karlp/ktwinkler/README.md

# kTwinkler

Replacement controller board for some "common" battery powered led fairy lights...
