karlp/ktwinkler/fw/README.md

# fw options
Given that there's multiple boards, with multiple hardwares in this repo, the firmware really has a few options.  At the time of writing, work is focused on esp32 variants, and using them with home assistant, and/or Artnet or sACN/E1.31

# micropython builds

## One time prep
We prefer using idf in a container, however, the original "make submodules" targets inside esp32 aren't happy with that.  Just update the submodules we know ahead of time.
```
git submodule update --init lib/micropython-lib lib/berkeley-db-1.xx
```

## (re)build
(The extra .. is so that _this_ repo's top level git repository is accessible for versioning)
```
podman run --rm -v ..:/project:Z -w /project/fw/boards/ktwinkler-multi-r2025-12 -e HOME=/tmp docker.io/espressif/idf:v5.5.4 idf.py  build
podman run --rm -v ..:/project:Z -w /project/fw/boards/ktwinkler-24-basic1 -e HOME=/tmp docker.io/espressif/idf:v5.5.4 idf.py -b 921660 build
```

# To flash.
```
podman run --rm --device /dev/ttyACM0 -v ..:/project:Z -w /project/fw/boards/ktwinkler-multi-r2025-12 -e HOME=/tmp docker.io/espressif/idf:v5.5.4 idf.py -b 921660 build erase-flash flash
podman run --rm --device /dev/ttyACM0 -v ..:/project:Z -w /project/fw/boards/ktwinkler-24-basic1 -e HOME=/tmp docker.io/espressif/idf:v5.5.4 idf.py -b 921660 build erase-flash flash
```
