karlp/ktwinkler/notes.halloween.2026.md

# For next year
## use one of the 40V nmosx4 boards to be an artnet+skeleton arms controller.
This will:
 - save a bunch of separate cabling
 - be signifcantly less hassle remembering how to wire up a faker board.

## While I'm at it, order some other shit that turned up:

* 3.5mm x2 wire side, fistful
* banana to screw jack?
* banana to wire for making my own alternate leads.  somehow I'v erun out

## Get a pile of 2 terminal waterproof connectors
Using the euroconnectors is... pretty ish for icelandic weather.

### https://www.aliexpress.com/item/1005013383786555.html
  IDC, no three way, claims 6A, no waterproof claims

### https://www.aliexpress.com/item/1005012276167495.html
"M12" but wow, need to be careful with the keying.
This sort of thing though...

### https://www.aliexpress.com/item/1005007842926046.html
"weipo" style, way too expensive

### https://www.aliexpress.com/item/1005006974116902.html
screw together with lever connectors inside?
might be more flexible for multiple wire sizes?
but, no, I want.... m12 style to hang out of everything, it's the easiest, then mount long lines to each led string I need?

### winner, m12, flat side, extensions and bare ends
https://www.aliexpress.com/item/1005006619215145.html
need to find the female end for putting into the control boxes...

### alternate, m12, notched key,
female and male options, pigtails, 
https://www.aliexpress.com/item/1005010790895370.html

honestly, that keying style does actaully seem yo be more prevalent?

### https://www.aliexpress.com/item/1005012783296378.html
"CableMate store"
same notched style, offers different gauge wire, which instantly makes me trust them more :)

GO over this again. m10, vs m12, vs m16!!!
