karlp/ktwinkler/scifi/EMerge_example_pack_2_2/examples/DielectricRod.step

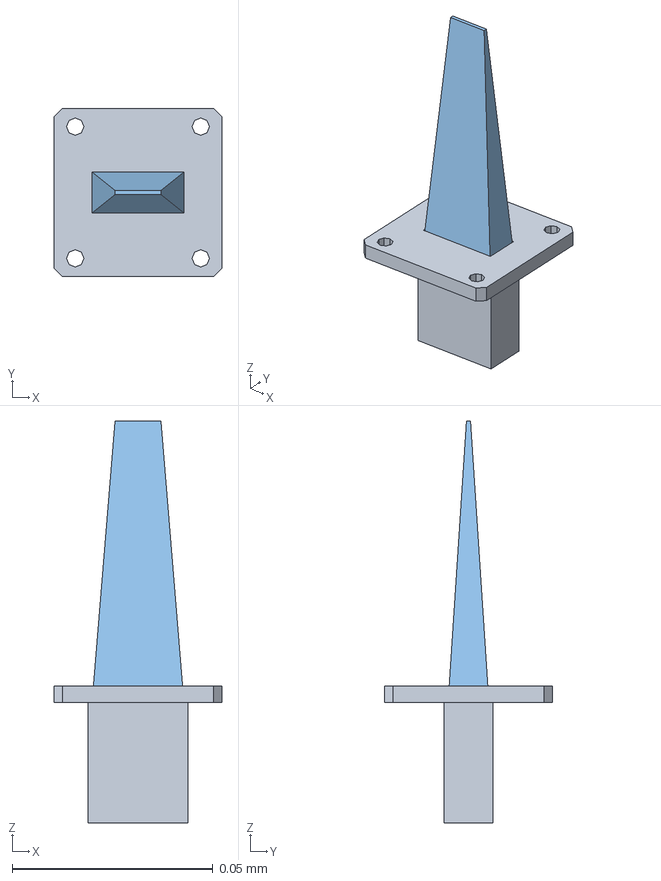
[picture p1: CAD file, 2025-12-28]
scifi/EMerge_example_pack_2_2/examples/DielectricRod.step
0.0417 x 0.0417 x 0.1 mm
