karlp/ktwinkler/hw/ktwinkler-24-basic1/ktwinkler-24-basic1.kicad_pcb

## KiCad design hw/ktwinkler-24-basic1/ktwinkler-24-basic1.kicad_pcb (2026-09-21)

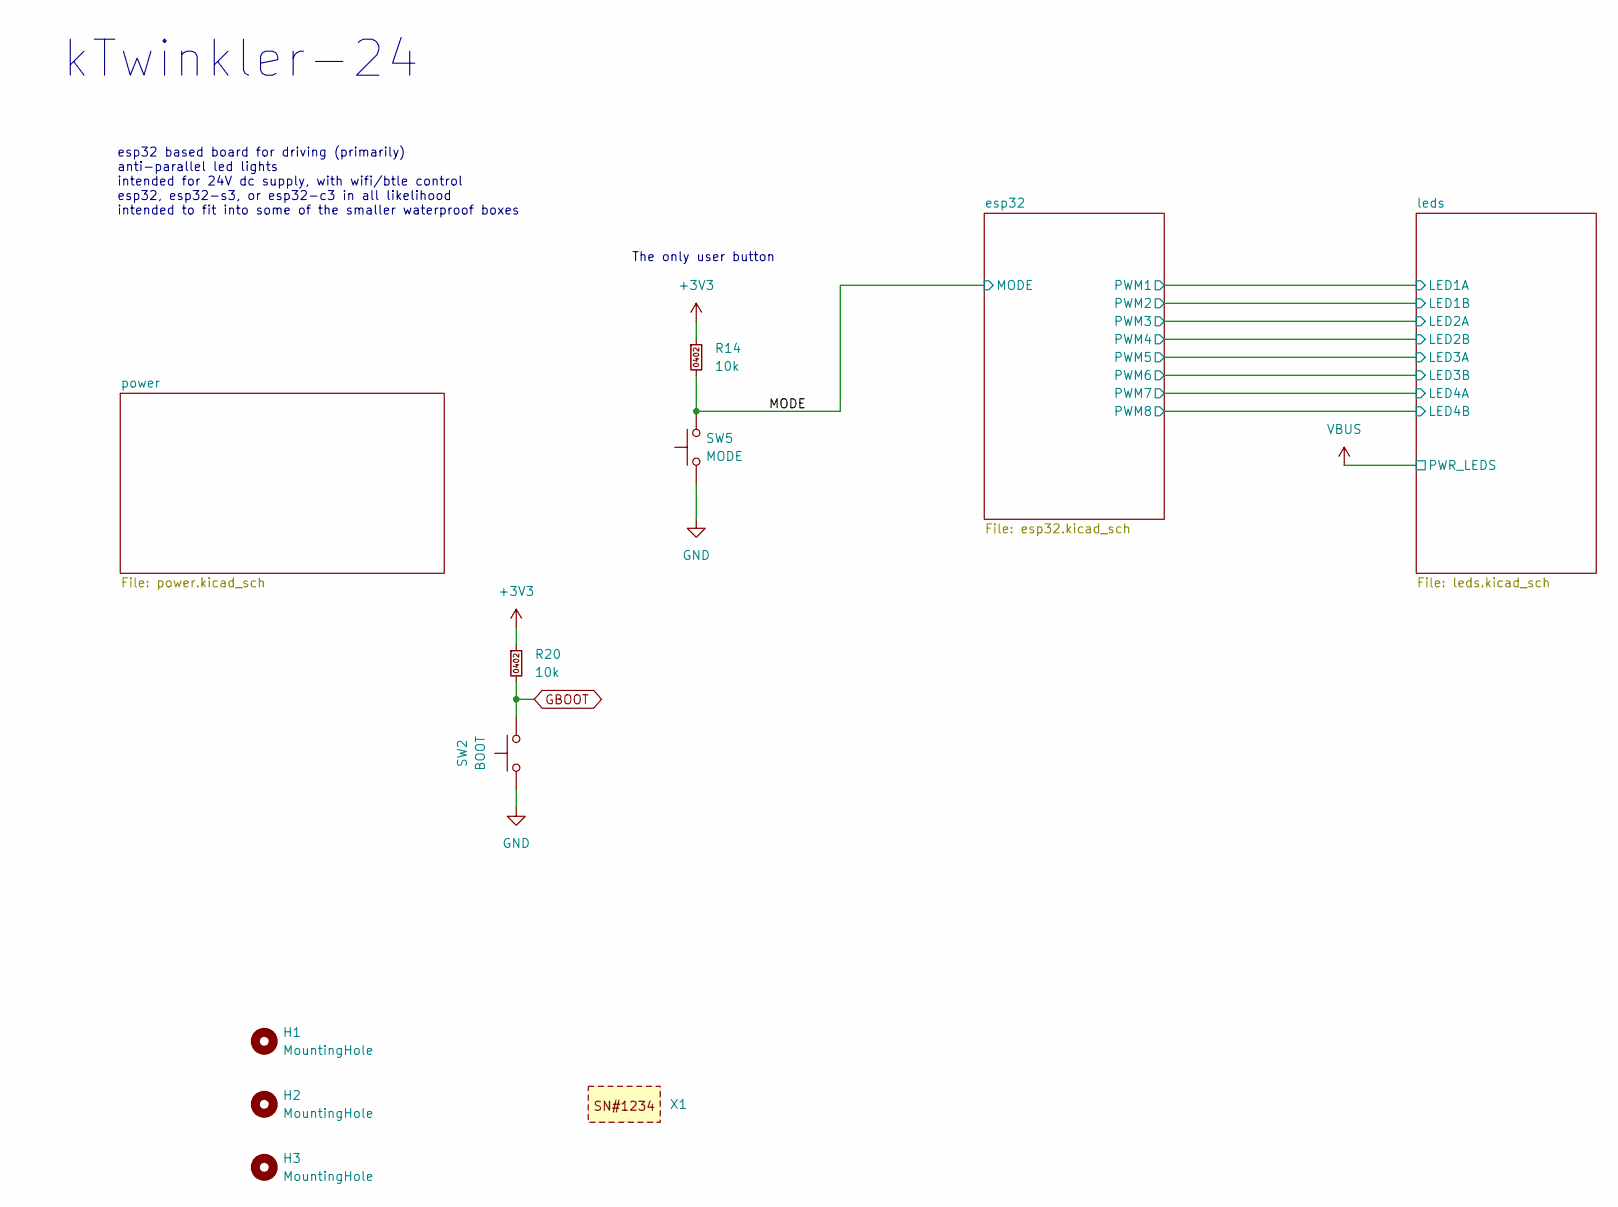
[picture p2: schematic ktwinkler-24-basic1.kicad_sch]

Parts:
H1, H2, H3: MountingHole; MountingHole_3.2mm_M3
R14, R20: 10k; R_0402_1005Metric; MPN 0402WGF1002TCE; LCSC Part # C25744
SW2: BOOT; SW_SPST_TL3342; MPN TS-1187A-B-A-B; jlcbasic basic
SW5: MODE; SW_SPST_TL3342; MPN TS-1187A-B-A-B; jlcbasic basic
X1: JLC_2D_BARCODE_8x8mm

Connections:
+3V3: R14.1, R20.1; also elsewhere on the board
/MODE: R14.2, SW5.2; also elsewhere on the board
GBOOT: R20.2, SW2.2; also elsewhere on the board
GND: SW2.1, SW5.1; also elsewhere on the board

Notes on the sheet:
esp32 based board for driving (primarily) anti-parallel led lights intended for 24V dc supply, with wifi/btle control esp32, esp32-s3, or esp32-c3 in all likelihood intended to fit into some of the smaller waterproof boxes
kTwinkler-24
The only user button

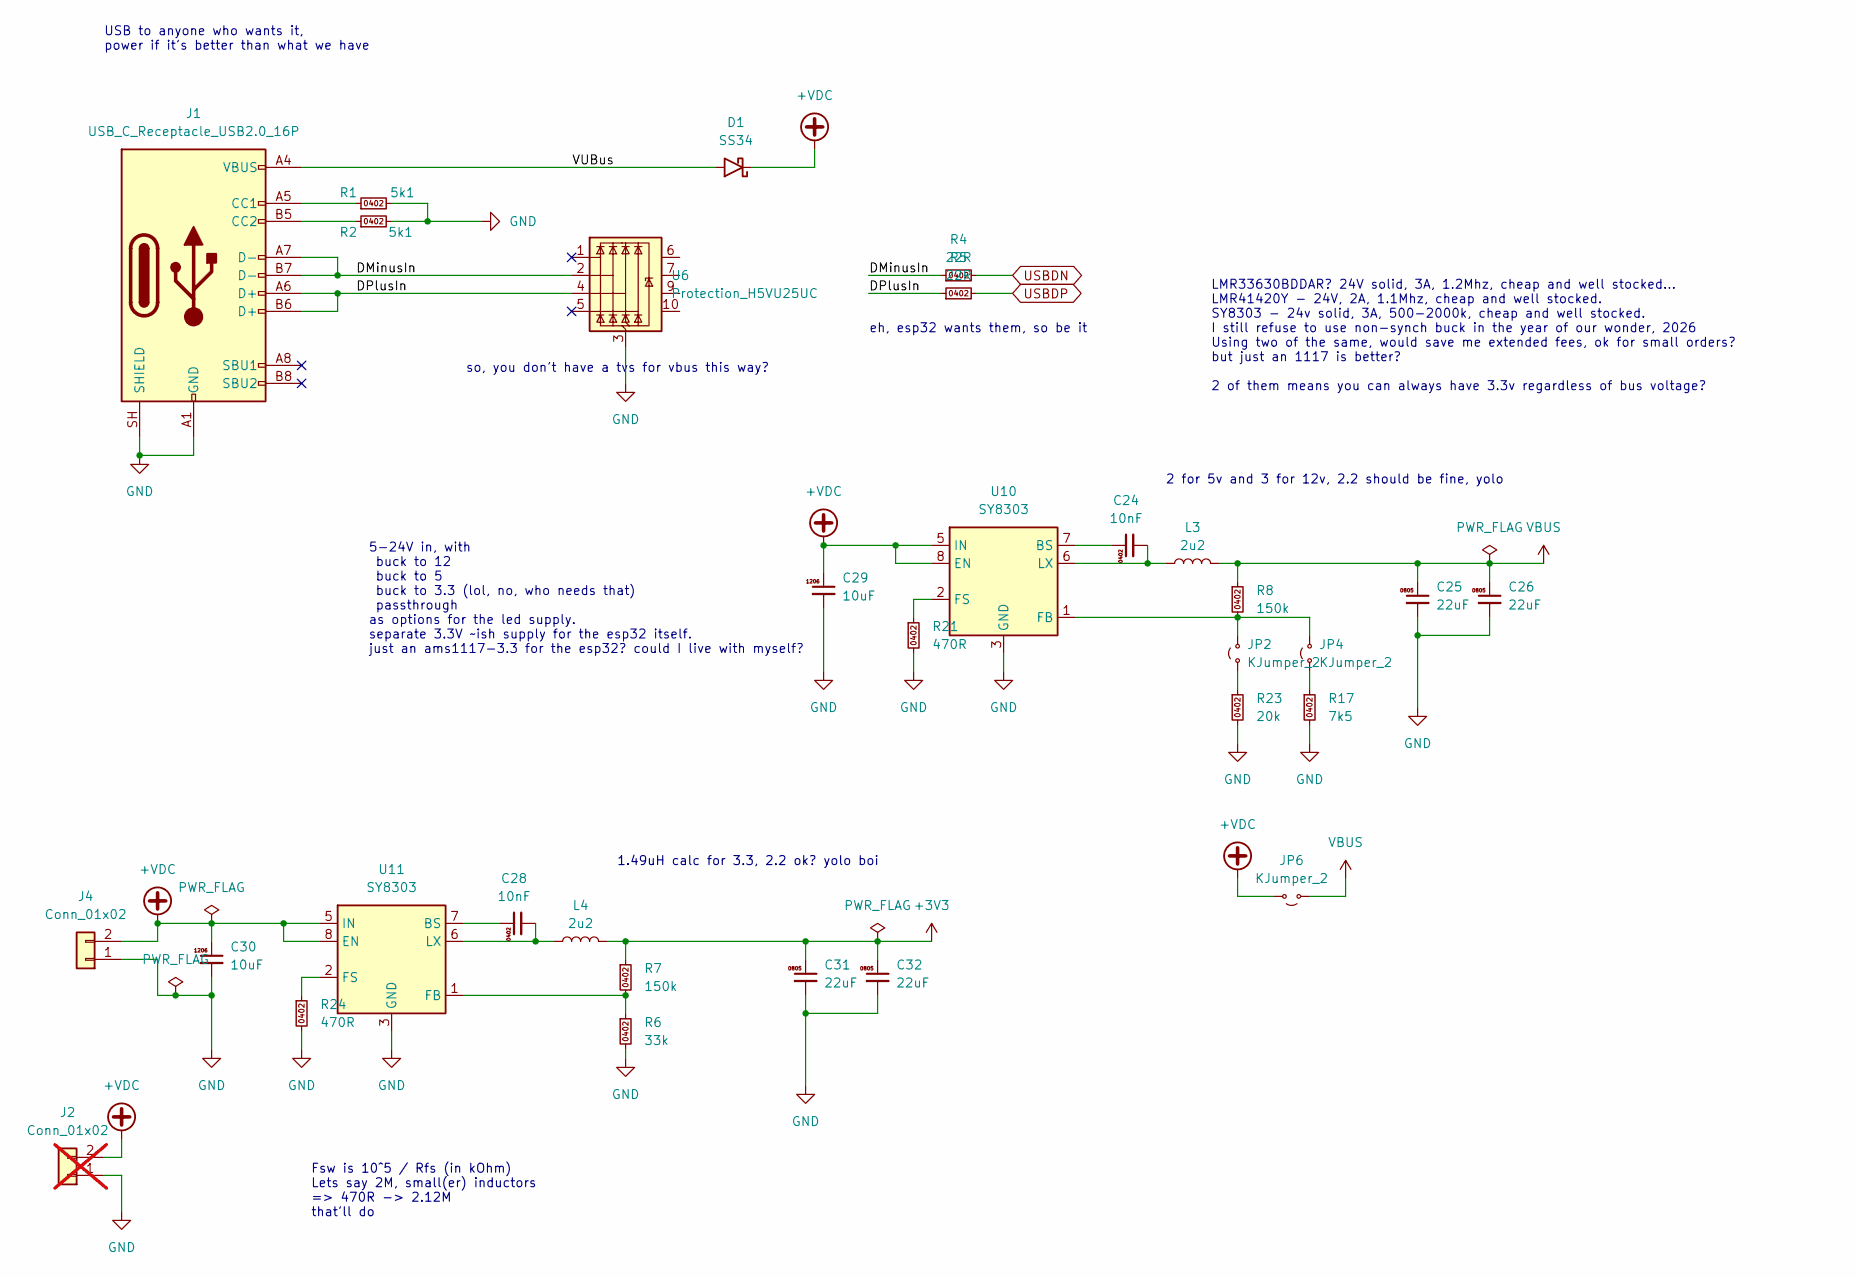
[picture p3: schematic power.kicad_sch]

Parts:
C24, C28: 10nF; C_0402_1005Metric; MPN CL05B103KB5NNNC; LCSC Part # C15195
C25, C26, C31, C32: 22uF; C_0805_2012Metric; MPN CL21A226MAQNNNE; LCSC Part # C45783
C29, C30: 10uF; C_1206_3216Metric; MPN CL31A106KBHNNNE; LCSC Part # C13585
D1: SS34; D_SMA; MPN SS34; LCSC Part # C8678
J1: USB_C_Receptacle_USB2.0_16P; USB_C_Receptacle_GCT_USB4105-xx-A_16P_TopMnt_Horizontal; MPN GT-USB-7010ASV; LCSC Part # C2988369
J2: Conn_01x02; PinHeader_1x02_P2.54mm_Vertical; not fitted
J4: Conn_01x02; PhoenixContact_MCV_1,5_2-G-3.81_1x02_P3.81mm_Vertical; MPN WJ15EDGVC-3.81-02P-14-00A; LCSC Part # C8396
JP2, JP4, JP6: KJumper_2; PinHeader_1x02_P2.54mm_Vertical
L3, L4: 2u2; L_Changjiang_FNR4030S; MPN FNR4030S2R2MT; LCSC Part # C167869
R1, R2: 5k1; R_0402_1005Metric; MPN 0402WGF5101TCE; LCSC Part # C25905
R4, R5: 22R; R_0402_1005Metric; MPN 0402WGF220JTCE; LCSC Part # C25092
R6: 33k; R_0402_1005Metric; MPN 0402WGF3302TCE; LCSC Part # C25779
R7, R8: 150k; R_0402_1005Metric; MPN 0402WGF1503TCE; LCSC Part # C25755
R17: 7k5; R_0402_1005Metric; MPN 0402WGF7501TCE; LCSC Part # C25918
R21, R24: 470R; R_0402_1005Metric; MPN 0402WGF4700TCE; LCSC Part # C25117
R23: 20k; R_0402_1005Metric; MPN 0402WGF2002TCE; LCSC Part # C25765
U6: Protection_H5VU25UC; Diodes_UDFN-10_1x2.5mm_P0.5mm; MPN H5VU25UC; jlcbasic preferred
U10, U11: SY8303; TSOT-23-8; LCSC Part # C97054

Connections:
+3V3: C31.1, C32.1, L4.2, R7.1; also elsewhere on the board
+VDC: C29.1, C30.1, D1.1 (K), J2.2, J4.2, JP6.2 (B), U10.5 (IN), U10.8 (EN), U11.5 (IN), U11.8 (EN)
/power/DMinusIn: J1.A7 (D-), J1.B7 (D-), R4.1, U6.2 (I/O2)
/power/DPlusIn: J1.A6 (D+), J1.B6 (D+), R5.1, U6.4 (I/O3)
/power/VUBus: D1.2 (A), J1.A4 (VBUS), J1.A9 (VBUS), J1.B4 (VBUS), J1.B9 (VBUS)
GND: C25.2, C26.2, C29.2, C30.2, C31.2, C32.2, J1.A1 (GND), J1.A12 (GND), J1.B1 (GND), J1.B12 (GND), J1.SH (SHIELD), J2.1, J4.1, R1.2, R2.2, R6.2, R17.2, R21.2, R23.2, R24.2, U6.3 (GND), U6.8 (GND), U10.3 (GND), U10.4 (GND), U11.3 (GND), U11.4 (GND); also elsewhere on the board
unnamed: J1.A5 (CC1), R1.1
unnamed: J1.B5 (CC2), R2.1
unnamed: JP2.1 (A), R23.1
unnamed: JP2.2 (B), JP4.2 (B), R8.2, U10.1 (FB)
unnamed: JP4.1 (A), R17.1
unnamed: C24.1, U10.7 (BS)
unnamed: R21.1, U10.2 (FS)
unnamed: C24.2, L3.1, U10.6 (LX)
unnamed: C28.1, U11.7 (BS)
unnamed: R6.1, R7.2, U11.1 (FB)
unnamed: R24.1, U11.2 (FS)
unnamed: C28.2, L4.1, U11.6 (LX)
USBDN: R4.2; also elsewhere on the board
USBDP: R5.2; also elsewhere on the board
VBUS: C25.1, C26.1, JP6.1 (A), L3.2, R8.1; also elsewhere on the board

Notes on the sheet:
LMR33630BDDAR? 24V solid, 3A, 1.2Mhz, cheap and well stocked... LMR41420Y - 24V, 2A, 1.1Mhz, cheap and well stocked. SY8303 - 24v solid, 3A, 500-2000k, cheap and well stocked. I still refuse to use non-synch buck in the year of our wonder, 2026 Using two of the same, would save me extended fees, ok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
5-24V in, with buck to 12 buck to 5 buck to 3.3 (lol, no, who needs that) passthrough as options for the led supply. separate 3.3V ~ish supply for the esp32 itself. just an ams1117-3.3 for the esp32? could I live with myself?
USB to anyone who wants it, power if it's better than what we have
so, you don't have a tvs for vbus this way?
1.49uH calc for 3.3, 2.2 ok? yolo boi
Fsw is 10^5 / Rfs (in kOhm) Lets say 2M, small(er) inductors => 470R -> 2.12M that'll do
eh, esp32 wants them, so be it
2 for 5v and 3 for 12v, 2.2 should be fine, yolo

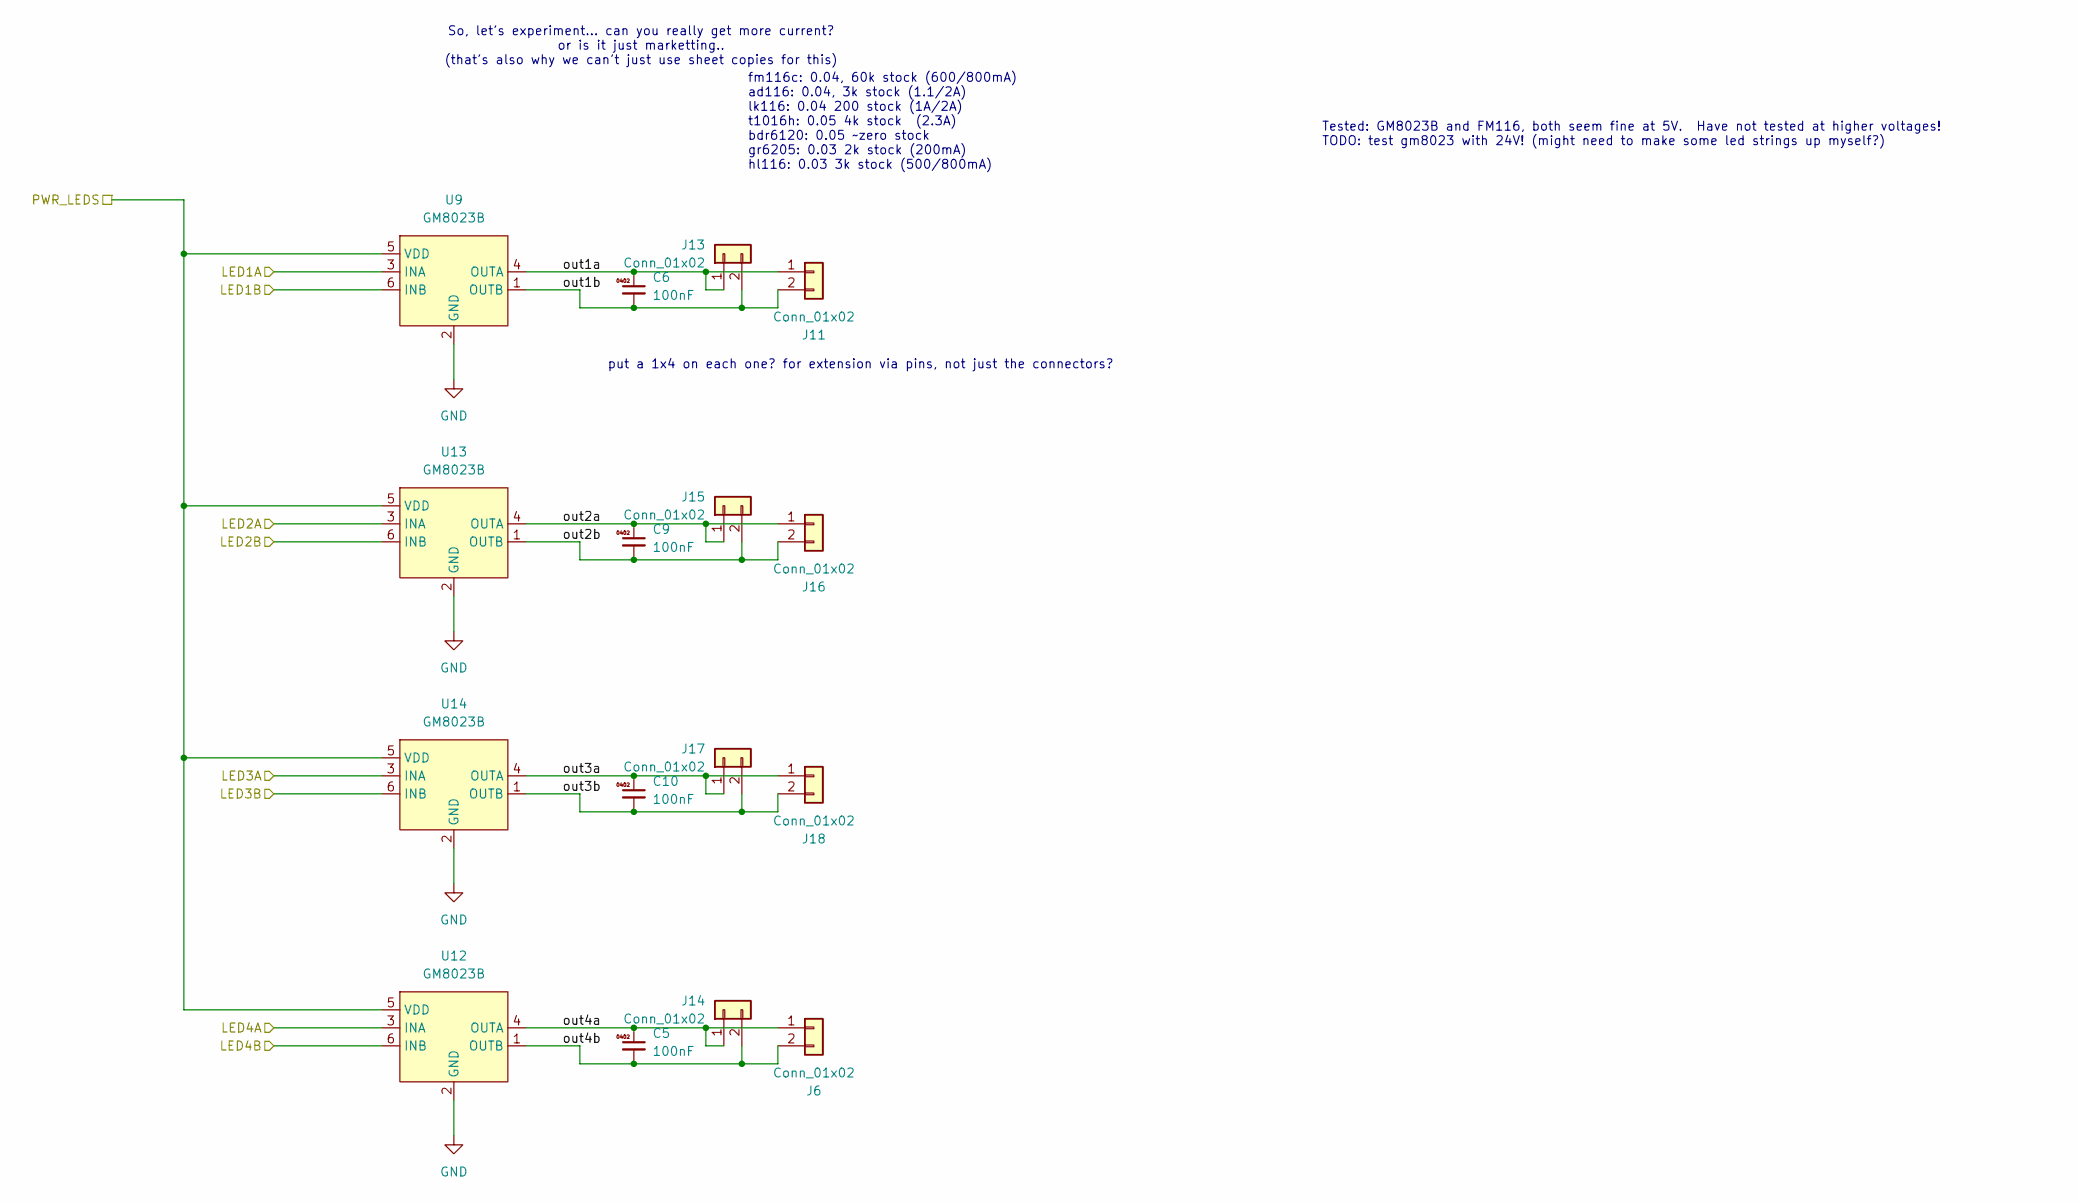
[picture p4: schematic leds.kicad_sch]

Parts:
C5, C6, C9, C10: 100nF; C_0402_1005Metric; MPN CL05B104KO5NNNC; LCSC Part # C1525
J6, J11, J16, J18: Conn_01x02; PhoenixContact_MCV_1,5_2-G-3.81_1x02_P3.81mm_Vertical; MPN WJ15EDGVC-3.81-02P-14-00A; LCSC Part # C8396
J13, J14, J15, J17: Conn_01x02; TestPoint_2Pads_Pitch2.54mm_Drill0.8mm
U9, U12, U13, U14: GM8023B; SOT-23-6; MPN GM8023B; LCSC Part # C269871

Connections:
/esp32/PWM1: U9.3 (INA); also elsewhere on the board
/esp32/PWM2: U9.6 (INB); also elsewhere on the board
/esp32/PWM3: U13.3 (INA); also elsewhere on the board
/esp32/PWM4: U13.6 (INB); also elsewhere on the board
/esp32/PWM5: U14.3 (INA); also elsewhere on the board
/esp32/PWM6: U14.6 (INB); also elsewhere on the board
/esp32/PWM7: U12.3 (INA); also elsewhere on the board
/esp32/PWM8: U12.6 (INB); also elsewhere on the board
/leds/out1a: C6.1, J11.1, J13.1, U9.4 (OUTA)
/leds/out1b: C6.2, J11.2, J13.2, U9.1 (OUTB)
/leds/out2a: C9.1, J15.1, J16.1, U13.4 (OUTA)
/leds/out2b: C9.2, J15.2, J16.2, U13.1 (OUTB)
/leds/out3a: C10.1, J17.1, J18.1, U14.4 (OUTA)
/leds/out3b: C10.2, J17.2, J18.2, U14.1 (OUTB)
/leds/out4a: C5.1, J6.1, J14.1, U12.4 (OUTA)
/leds/out4b: C5.2, J6.2, J14.2, U12.1 (OUTB)
GND: U9.2 (GND), U12.2 (GND), U13.2 (GND), U14.2 (GND); also elsewhere on the board
VBUS: U9.5 (VDD), U12.5 (VDD), U13.5 (VDD), U14.5 (VDD); also elsewhere on the board

Notes on the sheet:
So, let's experiment... can you really get more current? or is it just marketting.. (that's also why we can't just use sheet copies for this)
put a 1x4 on each one? for extension via pins, not just the connectors?
fm116c: 0.04, 60k stock (600/800mA) ad116: 0.04, 3k stock (1.1/2A) lk116: 0.04 200 stock (1A/2A) t1016h: 0.05 4k stock (2.3A) bdr6120: 0.05 ~zero stock gr6205: 0.03 2k stock (200mA) hl116: 0.03 3k stock (500/800mA)
Tested: GM8023B and FM116, both seem fine at 5V. Have not tested at higher voltages! TODO: test gm8023 with 24V! (might need to make some led strings up myself?)

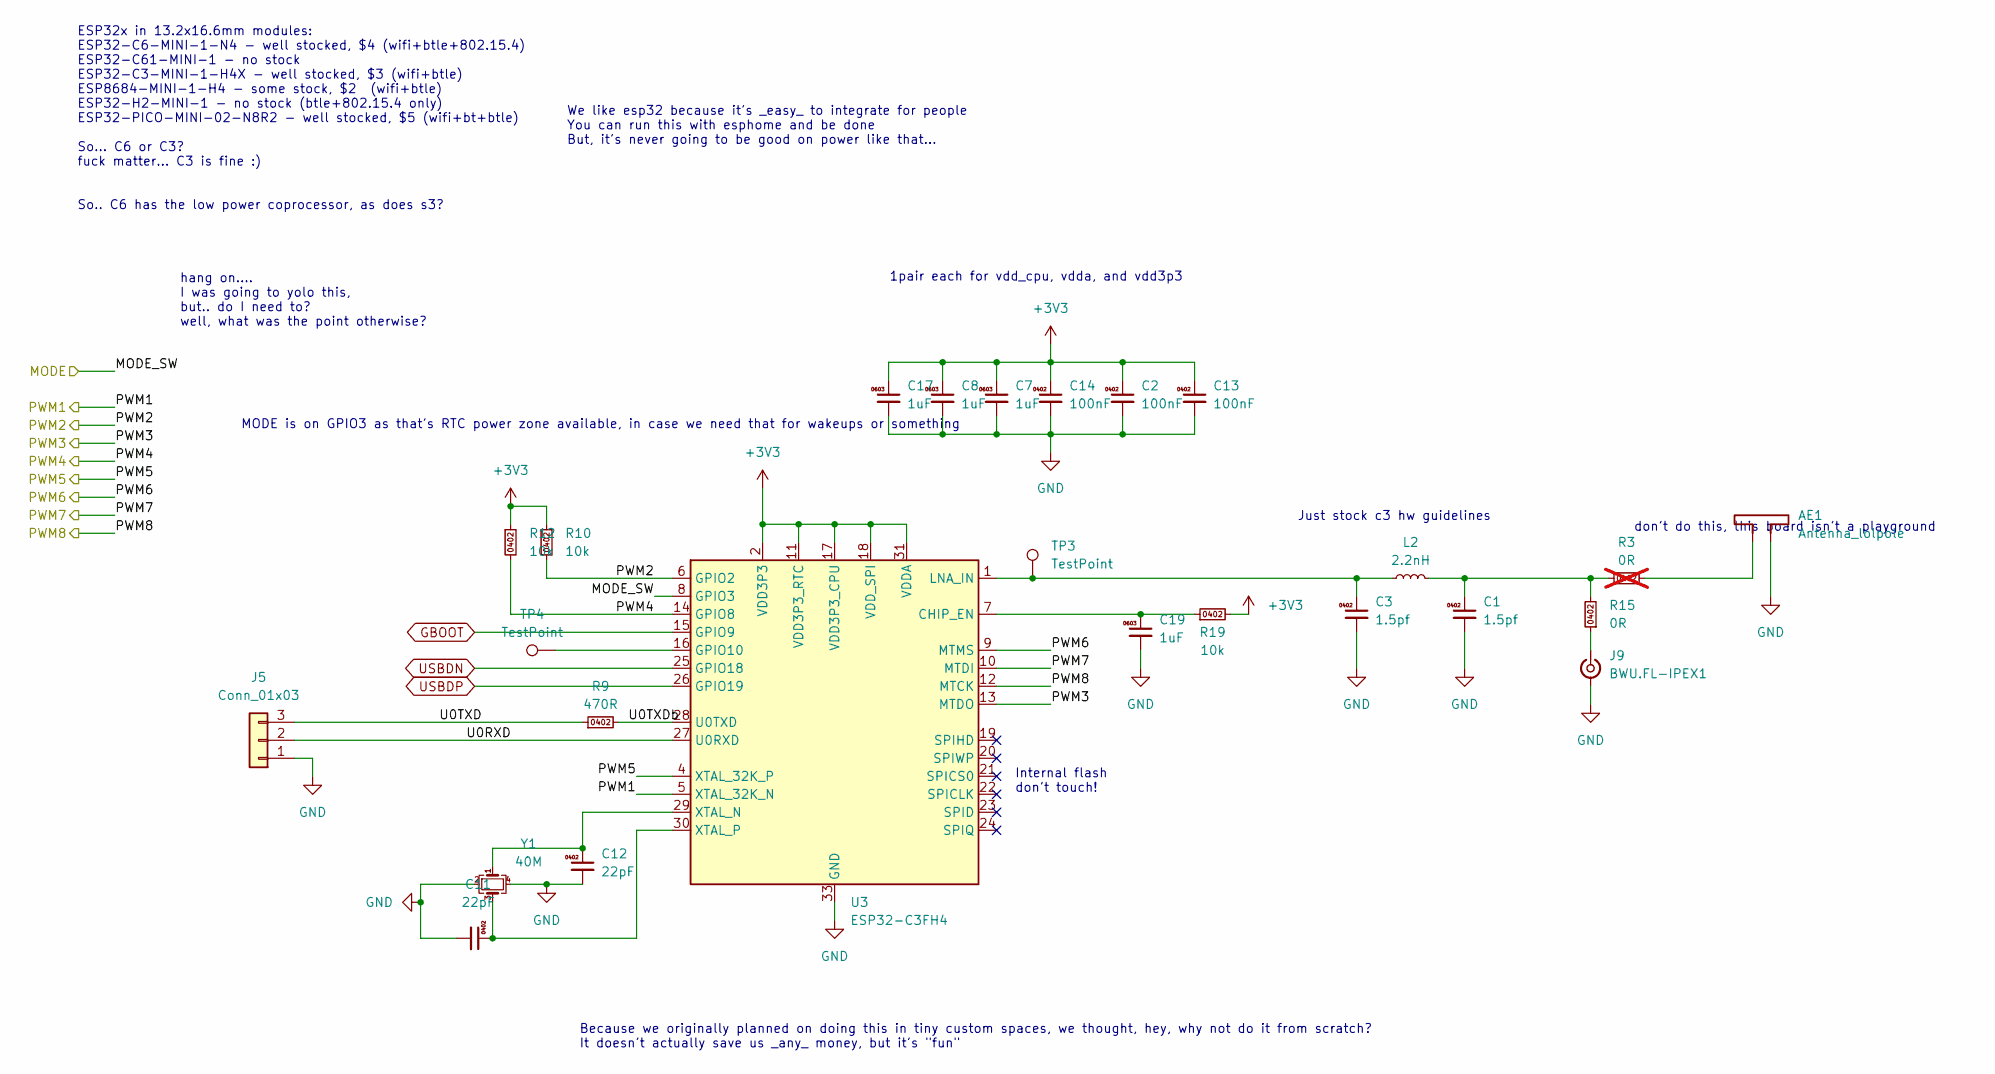
[picture p5: schematic esp32.kicad_sch]

Parts:
AE1: Antenna_lolpole; Texas_SWRA117D_2.4GHz_Left
C1, C3: 1.5pf; C_0402_1005Metric; MPN 0402CG1R5C500NT; LCSC Part # C1552
C2, C13, C14: 100nF; C_0402_1005Metric; MPN CL05B104KO5NNNC; LCSC Part # C1525
C7, C8, C17, C19: 1uF; C_0603_1608Metric; MPN CL10A105KB8NNNC; LCSC Part # C15849
C11, C12: 22pF; C_0402_1005Metric; MPN 0402CG220J500NT; LCSC Part # C1555
J5: Conn_01x03; PinHeader_1x03_P2.54mm_Vertical
J9: BWU.FL-IPEX1; U.FL_Hirose_U.FL-R-SMT-1_Vertical; MPN BWU.FL-IPEX1; LCSC Part # C5137195
L2: 2.2nH; L_0402_1005Metric; MPN LQG15HS2N2S02D; LCSC Part # C86061
R3: 0R; R_0402_1005Metric; MPN 0402WGF0000TCE; LCSC Part # C17168; not fitted
R9: 470R; R_0402_1005Metric; MPN 0402WGF4700TCE; LCSC Part # C25117
R10, R12, R19: 10k; R_0402_1005Metric; MPN 0402WGF1002TCE; LCSC Part # C25744
R15: 0R; R_0402_1005Metric; MPN 0402WGF0000TCE; LCSC Part # C17168
TP3, TP4: TestPoint; TestPoint_Pad_D1.0mm
U3: ESP32-C3FH4; QFN-32-1EP_5x5mm_P0.5mm_EP3.7x3.7mm; MPN ESP32-C3FH4; LCSC Part # C2858491
Y1: 40M; Crystal_SMD_2016-4Pin_2.0x1.6mm; MPN TAXM40M4ZHBCDT2T; LCSC Part # C424432

Connections:
+3V3: C2.1, C7.1, C8.1, C13.1, C14.1, C17.1, R10.1, R12.1, R19.2, U3.2 (VDD3P3), U3.3 (VDD3P3), U3.11 (VDD3P3_RTC), U3.17 (VDD3P3_CPU), U3.18 (VDD_SPI), U3.31 (VDDA), U3.32 (VDDA); also elsewhere on the board
/MODE: U3.8 (GPIO3); also elsewhere on the board
/esp32/PWM1: U3.5 (XTAL_32K_N); also elsewhere on the board
/esp32/PWM2: R10.2, U3.6 (GPIO2); also elsewhere on the board
/esp32/PWM3: U3.13 (MTDO); also elsewhere on the board
/esp32/PWM4: R12.2, U3.14 (GPIO8); also elsewhere on the board
/esp32/PWM5: U3.4 (XTAL_32K_P); also elsewhere on the board
/esp32/PWM6: U3.9 (MTMS); also elsewhere on the board
/esp32/PWM7: U3.10 (MTDI); also elsewhere on the board
/esp32/PWM8: U3.12 (MTCK); also elsewhere on the board
/esp32/U0RXD: J5.2, U3.27 (U0RXD)
/esp32/U0TXD: J5.3, R9.1
/esp32/U0TXDb: R9.2, U3.28 (U0TXD)
GBOOT: U3.15 (GPIO9); also elsewhere on the board
GND: AE1.2, C1.2, C2.2, C3.2, C7.2, C8.2, C11.2, C12.2, C13.2, C14.2, C17.2, C19.2, J5.1, J9.2 (Ext), U3.33 (GND), Y1.2, Y1.4; also elsewhere on the board
unnamed: AE1.1, R3.2
unnamed: C1.1, L2.2, R3.1, R15.2
unnamed: J9.1 (In), R15.1
unnamed: C19.1, R19.1, U3.7 (CHIP_EN)
unnamed: TP4.1 (1_1), U3.16 (GPIO10)
unnamed: C3.1, L2.1, TP3.1 (1_1), U3.1 (LNA_IN)
unnamed: C12.1, U3.29 (XTAL_N), Y1.1
unnamed: C11.1, U3.30 (XTAL_P), Y1.3
USBDN: U3.25 (GPIO18); also elsewhere on the board
USBDP: U3.26 (GPIO19); also elsewhere on the board

Notes on the sheet:
don't do this, this board isn't a playground
Internal flash don't touch!
hang on.... I was going to yolo this, but.. do I need to? well, what was the point otherwise?
MODE is on GPIO3 as that's RTC power zone available, in case we need that for wakeups or something
ESP32x in 13.2x16.6mm modules: ESP32-C6-MINI-1-N4 - well stocked, $4 (wifi+btle+802.15.4) ESP32-C61-MINI-1 - no stock ESP32-C3-MINI-1-H4X - well stocked, $3 (wifi+btle) ESP8684-MINI-1-H4 - some stock, $2 (wifi+btle) ESP32-H2-MINI-1 - no stock (btle+802.15.4 only) ESP32-PICO-MINI-02-N8R2 - well stoc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
Because we originally planned on doing this in tiny custom spaces, we thought, hey, why not do it from scratch? It doesn't actually save us _any_ money, but it's "fun"
We like esp32 because it's _easy_ to integrate for people You can run this with esphome and be done But, it's never going to be good on power like that...
1pair each for vdd_cpu, vdda, and vdd3p3
Just stock c3 hw guidelines

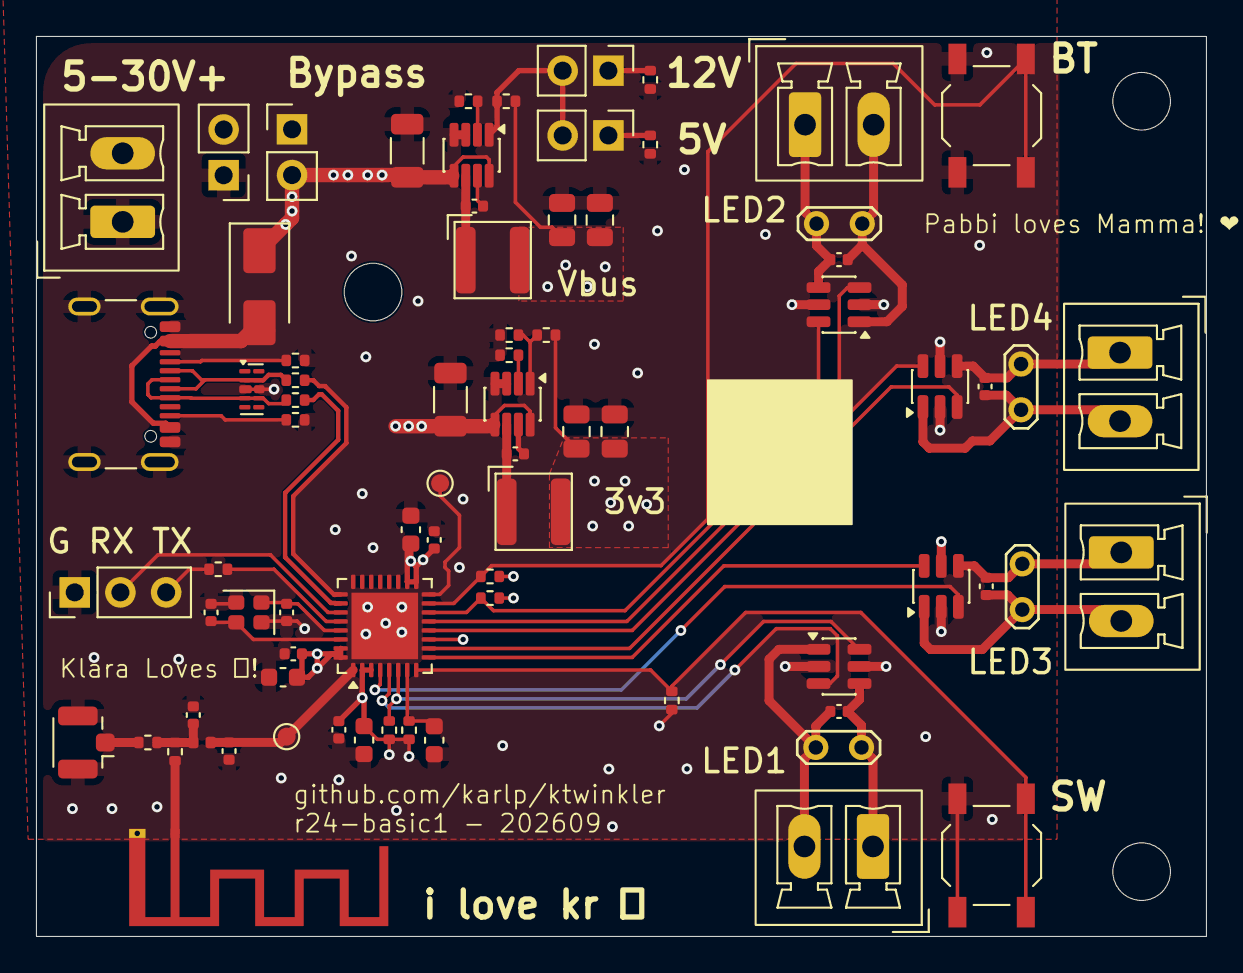
[picture p6: board ktwinkler-24-basic1.kicad_pcb from above]

Board: 4 copper layers, 65.0 x 50.0 mm, 80 parts (0 on the bottom side), 50 nets.
