karlp/ktwinkler/hw/ktwinkler-multi-r2025-12/ktwinkler-multi-r2025-12.kicad_pcb

## KiCad design hw/ktwinkler-multi-r2025-12/ktwinkler-multi-r2025-12.kicad_pcb (2026-04-19)

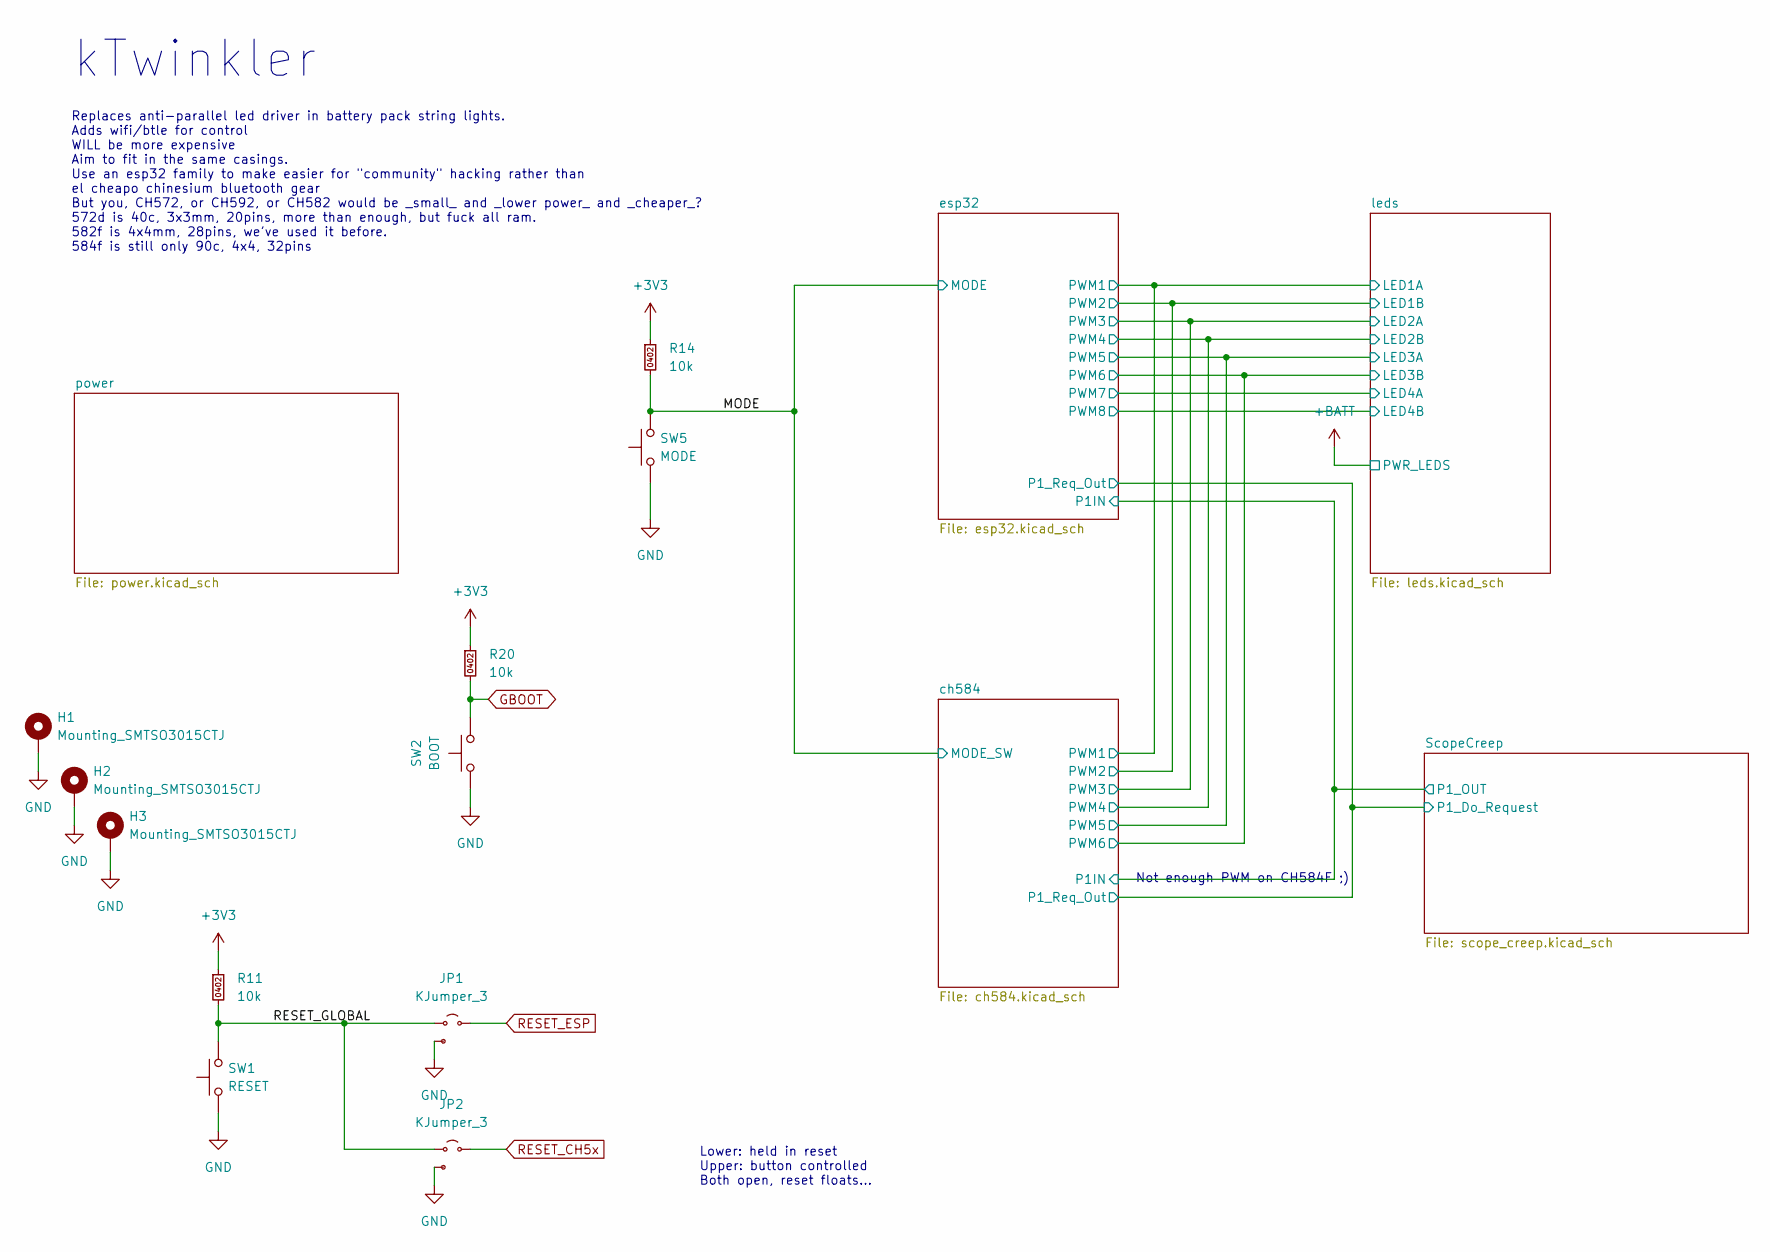
[picture p7: schematic ktwinkler-multi-r2025-12.kicad_sch]

Parts:
H1, H2, H3: Mounting_SMTSO3015CTJ; Mounting_SMTSO_M3_ALT2; MPN SMTSO3015CTJ; jlcbasic 0
JP1, JP2: KJumper_3; PinHeader_1x03_P2.54mm_Vertical
R11, R14, R20: 10k; R_0402_1005Metric; MPN 0402WGF1002TCE; LCSC Part # C25744
SW1: RESET; SW_SPST_TL3342; MPN TS-1187A-B-A-B; jlcbasic basic
SW2: BOOT; SW_SPST_TL3342; MPN TS-1187A-B-A-B; jlcbasic basic
SW5: MODE; SW_SPST_TL3342; MPN TS-1187A-B-A-B; jlcbasic basic

Connections:
+3V3: R11.1, R14.1, R20.1; also elsewhere on the board
/MODE: R14.2, SW5.2; also elsewhere on the board
/RESET_GLOBAL: JP1.1 (A), JP2.1 (A), R11.2, SW1.2
GBOOT: R20.2, SW2.2; also elsewhere on the board
GND: H1.1 (1_1), H2.1 (1_1), H3.1 (1_1), JP1.3 (B), JP2.3 (B), SW1.1, SW2.1, SW5.1; also elsewhere on the board
RESET_CH5x: JP2.2 (Comm); also elsewhere on the board
RESET_ESP: JP1.2 (Comm); also elsewhere on the board

Notes on the sheet:
Not enough PWM on CH584F ;)
Replaces anti-parallel led driver in battery pack string lights. Adds wifi/btle for control WILL be more expensive Aim to fit in the same casings. Use an esp32 family to make easier for "community" hacking rather than el cheapo chinesium bluetooth gear But you, CH572, or CH592, or CH582 would be _s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
Lower: held in reset Upper: button controlled Both open, reset floats...
kTwinkler

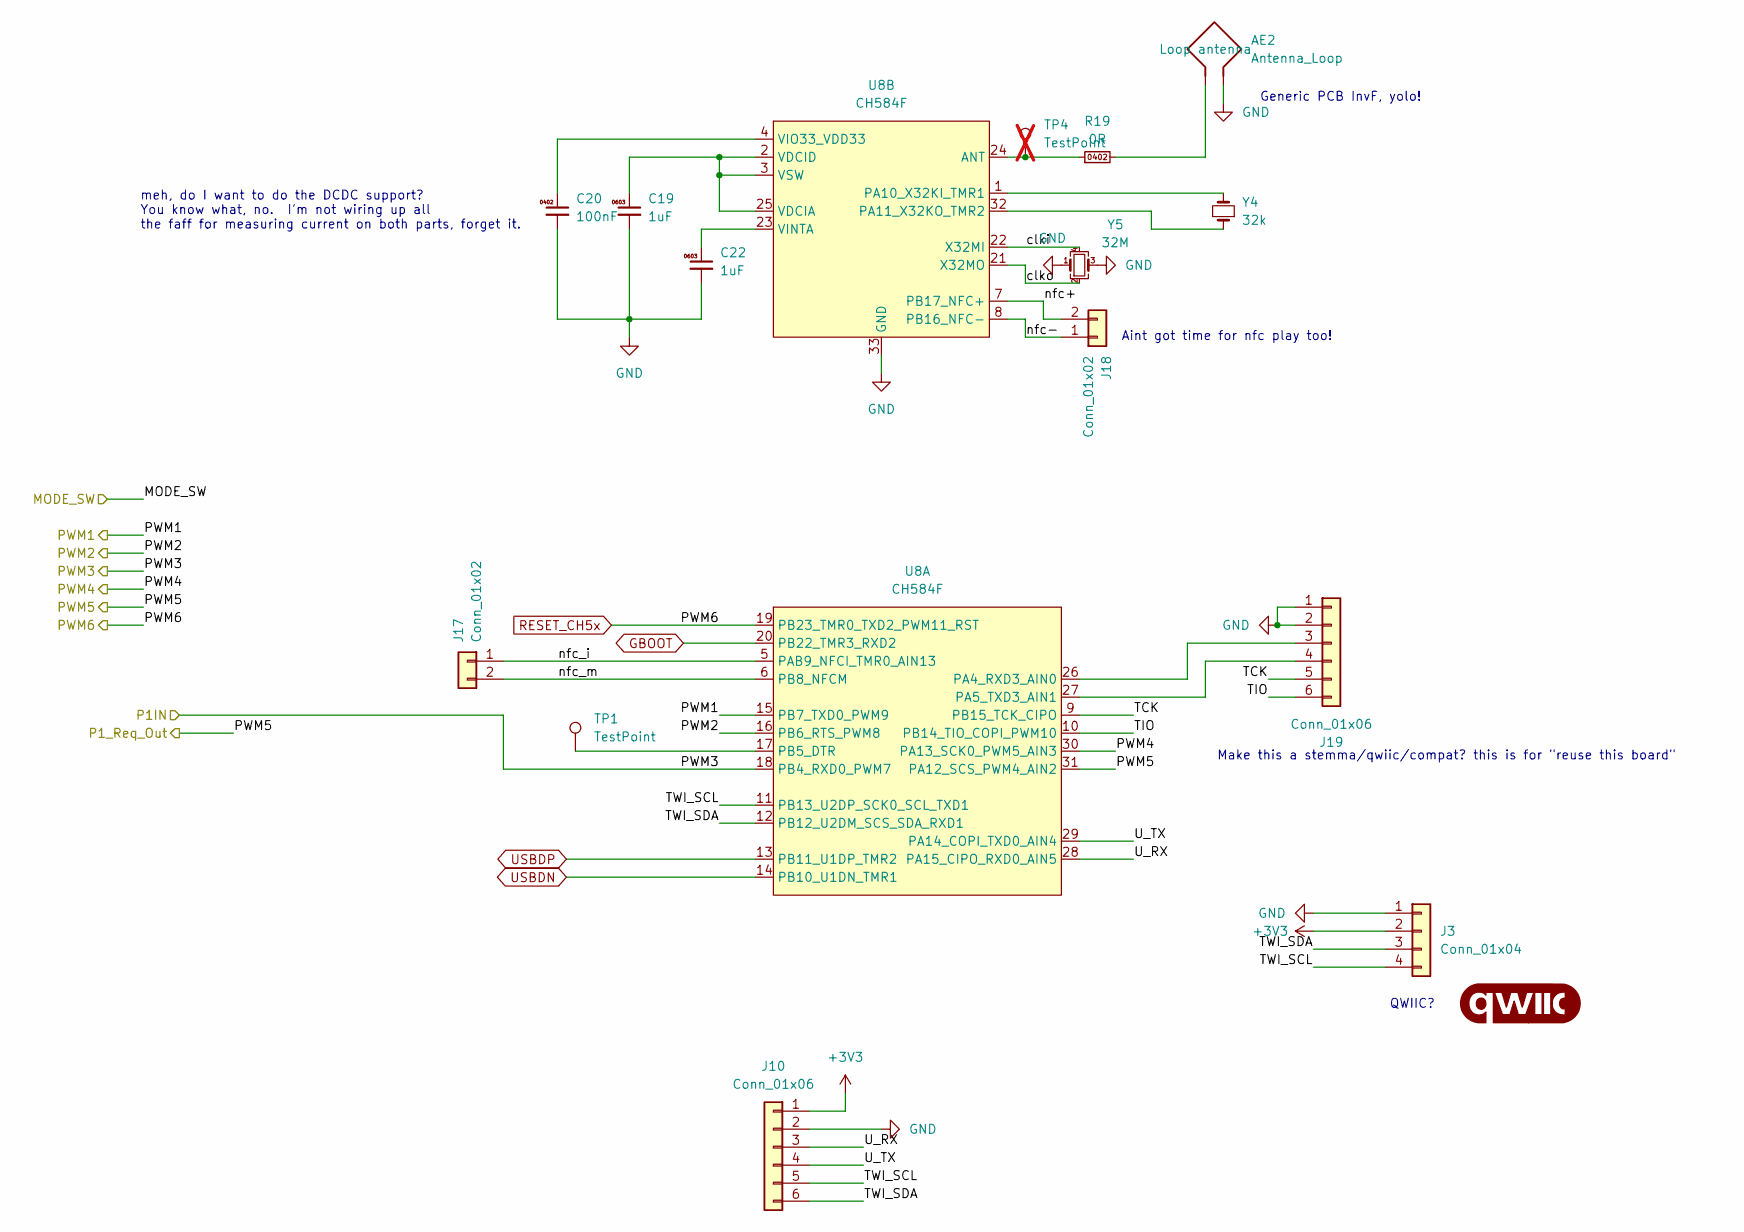
[picture p8: schematic ch584.kicad_sch]

Parts:
AE2: Antenna_Loop; ANT-F-1-2.4G-1.6MM-FR4-WCH-FLIP
C19, C22: 1uF; C_0603_1608Metric; MPN CL10A105KB8NNNC; LCSC Part # C15849
C20: 100nF; C_0402_1005Metric; MPN CL05B104KO5NNNC; LCSC Part # C1525
G1: qwiic_Logo; qwiic_4mm
J3: Conn_01x04; JST_SH_SM04B-SRSS-TB_1x04-1MP_P1.00mm_Horizontal; MPN 1.0-4PWB; LCSC Part # C2905006
J10, J19: Conn_01x06; PinHeader_1x06_P2.54mm_Vertical
J17, J18: Conn_01x02; TestPoint_2Pads_Pitch2.54mm_Drill0.8mm
R19: 0R; R_0402_1005Metric; MPN 0402WGF0000TCE; LCSC Part # C17168
TP1: TestPoint; TestPoint_THTPad_D1.0mm_Drill0.5mm
TP4: TestPoint; TestPoint_Pad_D1.0mm; not fitted
U8: CH584F; QFN-32-1EP_4x4mm_P0.4mm_EP2.65x2.65mm; MPN CH584F; LCSC Part # C42381468
Y4: 32k; Crystal_SMD_3215-2Pin_3.2x1.5mm; MPN Q13FC13500004; LCSC Part # C32346
Y5: 32M; Crystal_SMD_2016-4Pin_2.0x1.6mm; MPN XTM20032000DT00351005; LCSC Part # C37635332

Connections:
+3V3: J3.2, J10.1; also elsewhere on the board
/ch584/PWM1: U8.15 (PB7_TXD0_PWM9); also elsewhere on the board
/ch584/PWM2: U8.16 (PB6_RTS_PWM8); also elsewhere on the board
/ch584/PWM3: U8.18 (PB4_RXD0_PWM7); also elsewhere on the board
/ch584/PWM4: U8.30 (PA13_SCK0_PWM5_AIN3); also elsewhere on the board
/ch584/PWM5: U8.31 (PA12_SCS_PWM4_AIN2); also elsewhere on the board
/ch584/TCK: J19.5, U8.9 (PB15_TCK_CIPO)
/ch584/TIO: J19.6, U8.10 (PB14_TIO_COPI_PWM10)
/ch584/TWI_SCL: J3.4, J10.5, U8.11 (PB13_U2DP_SCK0_SCL_TXD1)
/ch584/TWI_SDA: J3.3, J10.6, U8.12 (PB12_U2DM_SCS_SDA_RXD1)
/ch584/U_RX: J10.3, U8.28 (PA15_CIPO_RXD0_AIN5)
/ch584/U_TX: J10.4, U8.29 (PA14_COPI_TXD0_AIN4)
/ch584/clki: U8.22 (X32MI), Y5.4
/ch584/clko: U8.21 (X32MO), Y5.2
/ch584/nfc+: J18.2, U8.7 (PB17_NFC+)
/ch584/nfc-: J18.1, U8.8 (PB16_NFC-)
/ch584/nfc_i: J17.1, U8.5 (PAB9_NFCI_TMR0_AIN13)
/ch584/nfc_m: J17.2, U8.6 (PB8_NFCM)
GBOOT: U8.20 (PB22_TMR3_RXD2); also elsewhere on the board
GND: AE2.2, C19.2, C20.2, C22.2, J3.1, J10.2, J19.1, J19.2, U8.33 (GND), Y5.1, Y5.3; also elsewhere on the board
unnamed: AE2.1, R19.2
unnamed: J19.3, U8.26 (PA4_RXD3_AIN0)
unnamed: J19.4, U8.27 (PA5_TXD3_AIN1)
unnamed: TP1.1 (1_1), U8.17 (PB5_DTR)
unnamed: R19.1, TP4.1 (1_1), U8.24 (ANT)
unnamed: U8.1 (PA10_X32KI_TMR1), Y4.2
unnamed: U8.32 (PA11_X32KO_TMR2), Y4.1
unnamed: C19.1, U8.2 (VDCID), U8.3 (VSW), U8.25 (VDCIA)
unnamed: C22.1, U8.23 (VINTA)
unnamed: C20.1, U8.4 (VIO33_VDD33)
RESET_CH5x: U8.19 (PB23_TMR0_TXD2_PWM11_RST); also elsewhere on the board
USBDN: U8.14 (PB10_U1DN_TMR1); also elsewhere on the board
USBDP: U8.13 (PB11_U1DP_TMR2); also elsewhere on the board

Notes on the sheet:
meh, do I want to do the DCDC support? You know what, no. I'm not wiring up all the faff for measuring current on both parts, forget it.
Generic PCB InvF, yolo!
QWIIC?
Aint got time for nfc play too!
Make this a stemma/qwiic/compat? this is for "reuse this board"
