karlp/ktwinkler/hw/ktwinkler-multi-r2025-12/ktwinkler-multi-r2025-12.kicad_pcb

## KiCad design hw/ktwinkler-multi-r2025-12/ktwinkler-multi-r2025-12.kicad_pcb (continued)

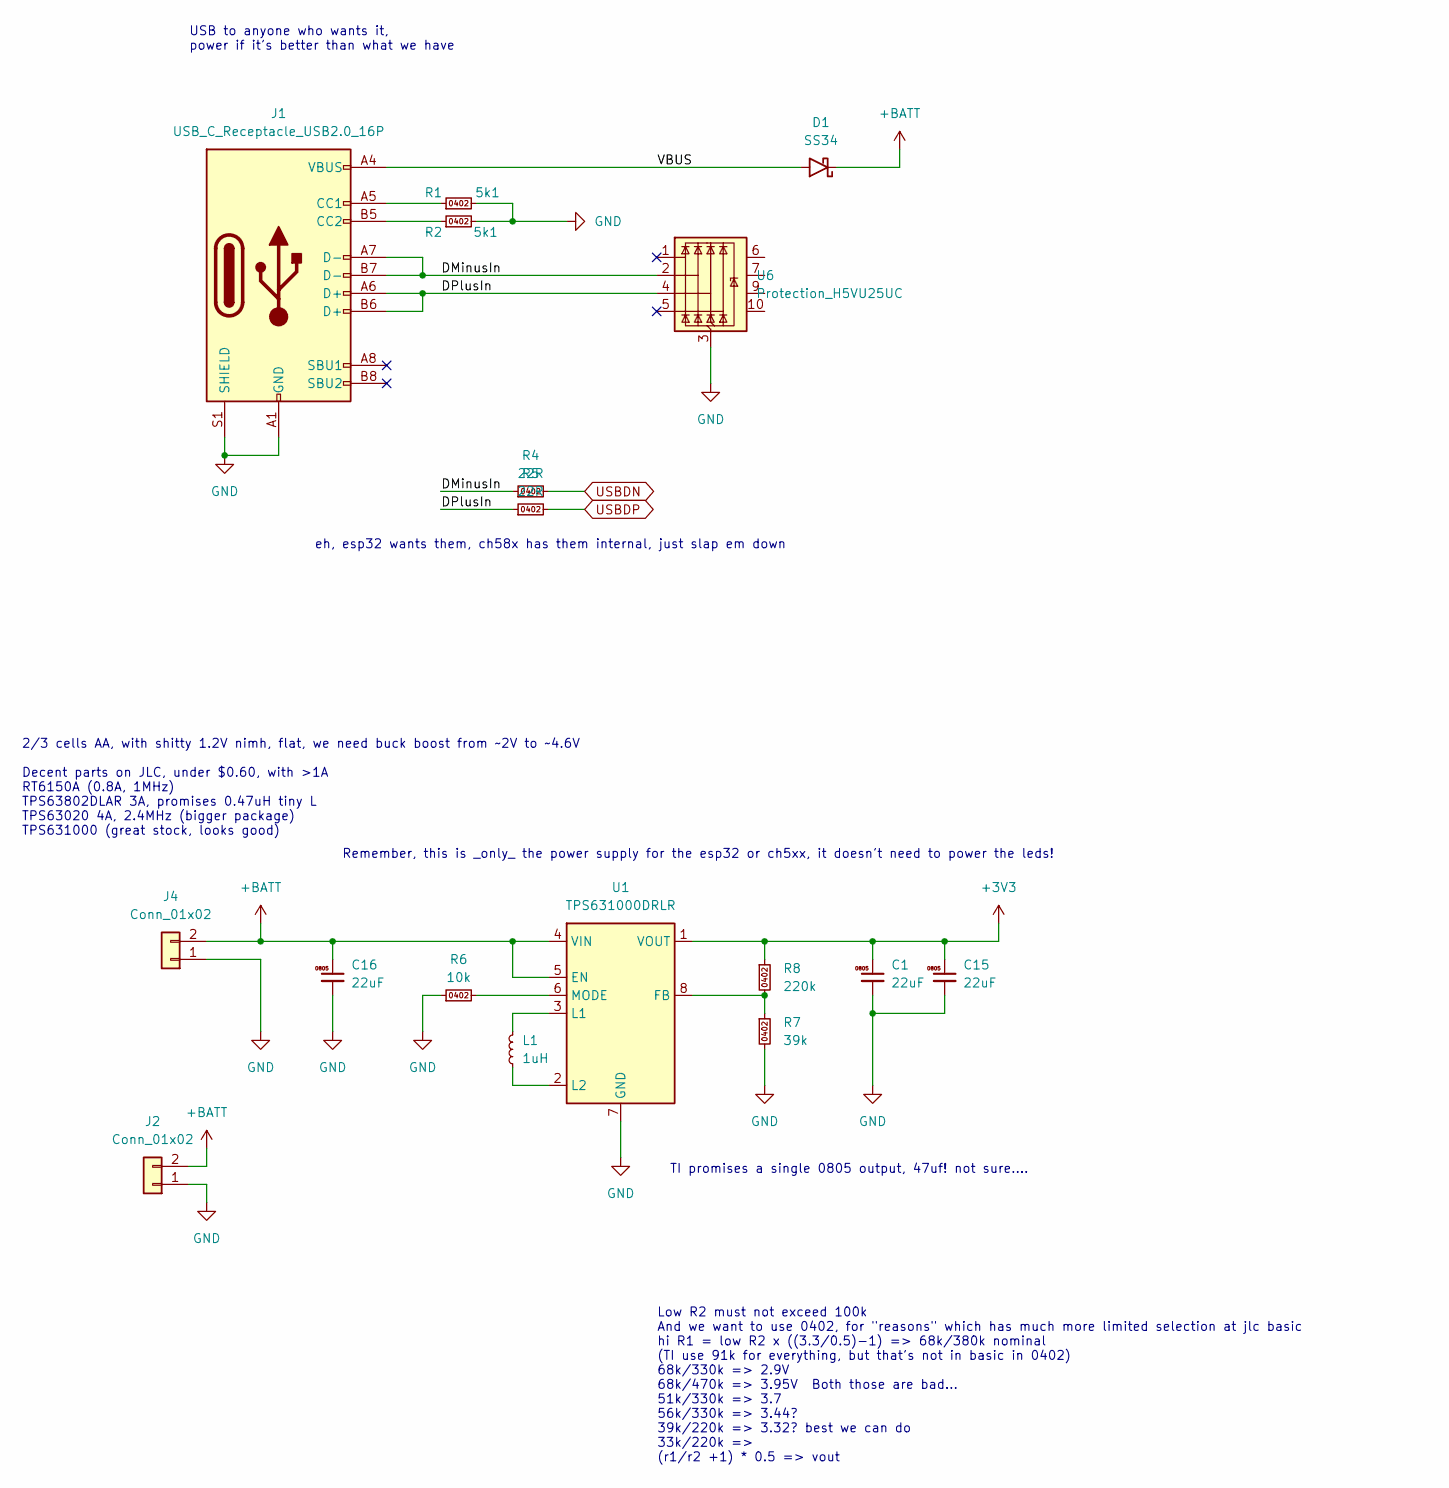
[picture p9: schematic power.kicad_sch]

Parts:
C1, C15, C16: 22uF; C_0805_2012Metric; MPN CL21A226MAQNNNE; LCSC Part # C45783
D1: SS34; D_SMA; MPN SS34; LCSC Part # C8678
J1: USB_C_Receptacle_USB2.0_16P; USB_C_Receptacle_GCT_USB4105-xx-A_16P_TopMnt_Horizontal; MPN GT-USB-7010ASV; LCSC Part # C2988369
J2: Conn_01x02; PinHeader_1x02_P2.54mm_Vertical
J4: Conn_01x02; PhoenixContact_MC_1,5_2-G-3.5_1x02_P3.50mm_Horizontal; MPN WJ15EDGVC-3.81-2P; LCSC Part # C8387
L1: 1uH; L_1206_3216Metric; MPN CMP321609UD1R0MT; LCSC Part # C139248
R1, R2: 5k1; R_0402_1005Metric; MPN 0402WGF5101TCE; LCSC Part # C25905
R4, R5: 22R; R_0402_1005Metric; MPN 0402WGF220JTCE; LCSC Part # C25092
R6: 10k; R_0402_1005Metric; MPN 0402WGF1002TCE; LCSC Part # C25744
R7: 39k; R_0402_1005Metric; MPN 0402WGF3902TCE; LCSC Part # C25783
R8: 220k; R_0402_1005Metric; MPN 0402WGF2203TCE; LCSC Part # C25767
U1: TPS631000DRLR; SOT-583-8; MPN TPS631000DRLR; LCSC Part # C5219190
U6: Protection_H5VU25UC; Diodes_UDFN-10_1.0x2.5mm_P0.5mm; MPN H5VU25UC; jlcbasic preferred

Connections:
+3V3: C1.1, C15.1, R8.1, U1.1 (VOUT); also elsewhere on the board
+BATT: C16.1, D1.1 (K), J2.2, J4.2, U1.4 (VIN), U1.5 (EN); also elsewhere on the board
/power/DMinusIn: J1.A7 (D-), J1.B7 (D-), R4.1, U6.2 (I/O2)
/power/DPlusIn: J1.A6 (D+), J1.B6 (D+), R5.1, U6.4 (I/O3)
/power/VBUS: D1.2 (A), J1.A4 (VBUS), J1.A9 (VBUS), J1.B4 (VBUS), J1.B9 (VBUS)
GND: C1.2, C15.2, C16.2, J1.A1 (GND), J1.A12 (GND), J1.B1 (GND), J1.B12 (GND), J1.S1 (SHIELD), J2.1, J4.1, R1.2, R2.2, R6.1, R7.2, U1.7 (GND), U6.3 (GND), U6.8 (GND); also elsewhere on the board
unnamed: J1.A5 (CC1), R1.1
unnamed: J1.B5 (CC2), R2.1
unnamed: R7.1, R8.2, U1.8 (FB)
unnamed: L1.2, U1.3 (L1)
unnamed: L1.1, U1.2 (L2)
unnamed: R6.2, U1.6 (MODE)
USBDN: R4.2; also elsewhere on the board
USBDP: R5.2; also elsewhere on the board

Notes on the sheet:
Low R2 must not exceed 100k And we want to use 0402, for "reasons" which has much more limited selection at jlc basic hi R1 = low R2 x ((3.3/0.5)-1) => 68k/380k nominal (TI use 91k for everything, but that's not in basic in 0402) 68k/330k => 2.9V 68k/470k => 3.95V Both those are bad... 51k/330k => 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
USB to anyone who wants it, power if it's better than what we have
2/3 cells AA, with shitty 1.2V nimh, flat, we need buck boost from ~2V to ~4.6V Decent parts on JLC, under $0.60, with >1A RT6150A (0.8A, 1MHz) TPS63802DLAR 3A, promises 0.47uH tiny L TPS63020 4A, 2.4MHz (bigger package) TPS631000 (great stock, looks good)
Remember, this is _only_ the power supply for the esp32 or ch5xx, it doesn't need to power the leds!
eh, esp32 wants them, ch58x has them internal, just slap em down
TI promises a single 0805 output, 47uf! not sure....

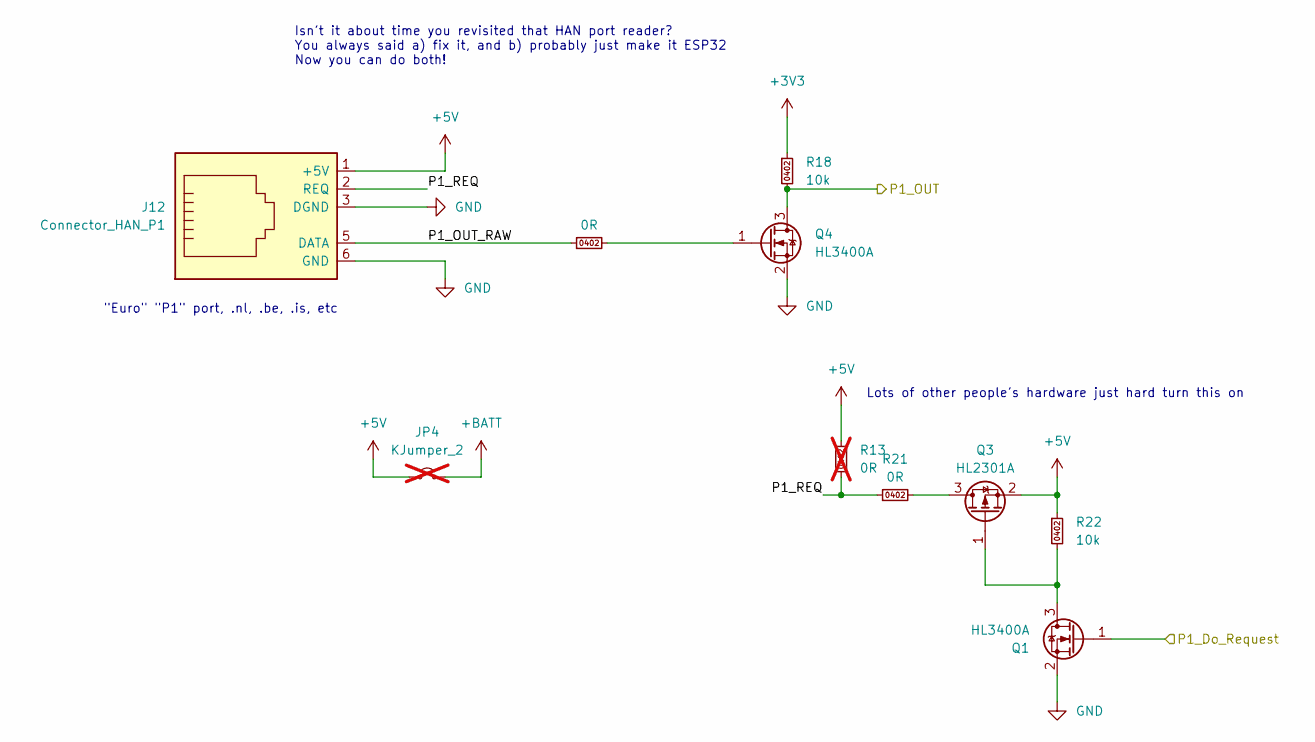
[picture p10: schematic scope_creep.kicad_sch]

Parts:
J12: Connector_HAN_P1; RJ25_Wayconn_MJEA-660X1_Horizontal; MPN R-RJ11R06P-A801
JP4: KJumper_2; TestPoint_2Pads_Pitch2.54mm_Drill0.8mm; not fitted
Q1, Q4: HL3400A; SOT-23; MPN HL3400A; LCSC Part # C7420348
Q3: HL2301A; SOT-23; jlcbasic preferred
R13: 0R; R_0402_1005Metric; MPN 0402WGF0000TCE; LCSC Part # C17168; not fitted
R17, R21: 0R; R_0402_1005Metric; MPN 0402WGF0000TCE; LCSC Part # C17168
R18, R22: 10k; R_0402_1005Metric; MPN 0402WGF1002TCE; LCSC Part # C25744

Connections:
+3V3: R18.1; also elsewhere on the board
+5V: J12.1 (+5V), JP4.1 (A), Q3.2 (S), R13.2, R22.1
+BATT: JP4.2 (B); also elsewhere on the board
/ScopeCreep/P1_OUT_RAW: J12.5 (DATA), R17.1
/ScopeCreep/P1_REQ: J12.2 (REQ), R13.1, R21.1
/ch584/PWM3: Q4.3 (D), R18.2; also elsewhere on the board
/ch584/PWM5: Q1.1 (G); also elsewhere on the board
GND: J12.3 (DGND), J12.6 (GND), Q1.2 (S), Q4.2 (S); also elsewhere on the board
unnamed: Q1.3 (D), Q3.1 (G), R22.2
unnamed: Q3.3 (D), R21.2
unnamed: Q4.1 (G), R17.2

Notes on the sheet:
Lots of other people's hardware just hard turn this on
Isn't it about time you revisited that HAN port reader? You always said a) fix it, and b) probably just make it ESP32 Now you can do both!
"Euro" "P1" port, .nl, .be, .is, etc

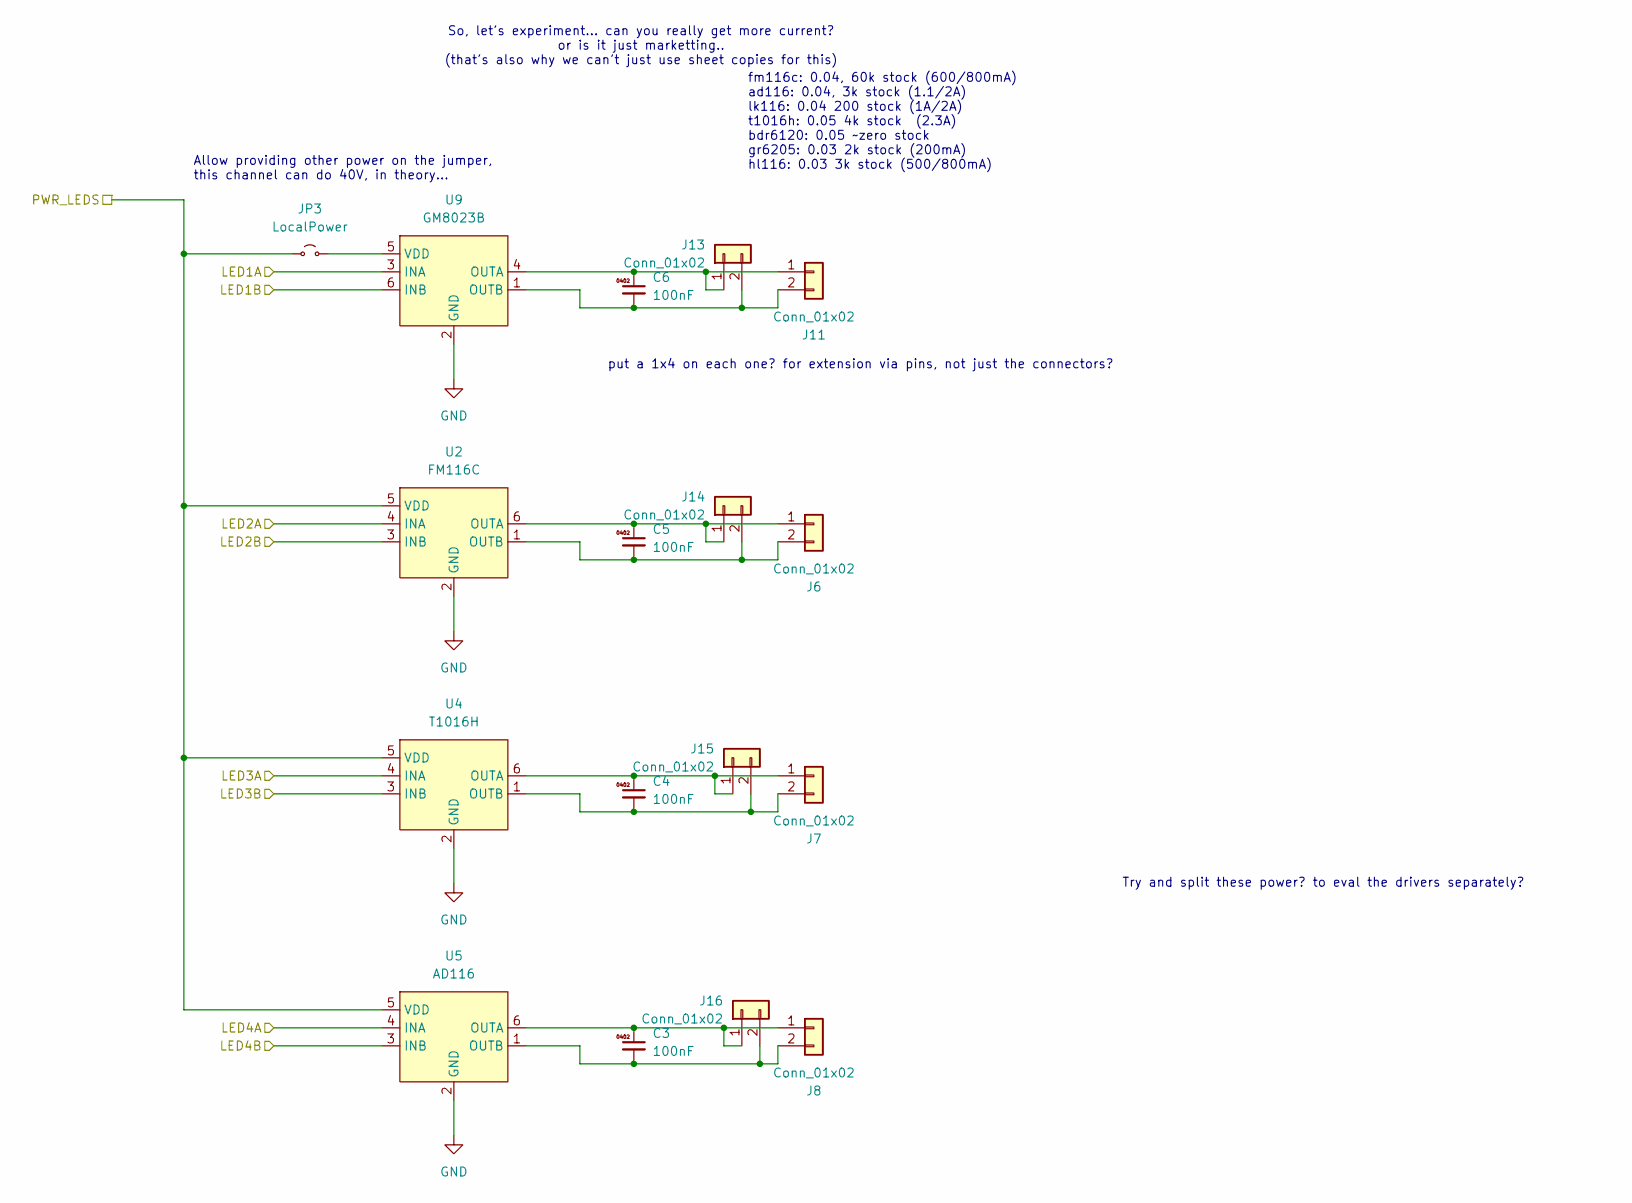
[picture p11: schematic leds.kicad_sch]

Parts:
C3, C4, C5, C6: 100nF; C_0402_1005Metric; MPN CL05B104KO5NNNC; LCSC Part # C1525
J6, J7, J8: Conn_01x02; PhoenixContact_MC_1,5_2-G-3.5_1x02_P3.50mm_Horizontal; MPN WJ15EDGVC-3.81-2P; LCSC Part # C8387
J11: Conn_01x02; PhoenixContact_MC_1,5_2-G-3.5_1x02_P3.50mm_Horizontal; MPN WJ15EDGRC-3.81-2P; LCSC Part # C8387
J13, J14, J15, J16: Conn_01x02; TestPoint_2Pads_Pitch2.54mm_Drill0.8mm
JP3: LocalPower; TestPoint_2Pads_Pitch2.54mm_Drill0.8mm
U2: FM116C; SOT-23-6; MPN FM116C; LCSC Part # C2802264
U4: T1016H; SOT-23-6; MPN T1016H; LCSC Part # C5142991
U5: AD116; SOT-23-6; MPN AD116; LCSC Part # C7463412
U9: GM8023B; SOT-23-6; MPN GM8023B; LCSC Part # C269871

Connections:
+BATT: JP3.1 (A), U2.5 (VDD), U4.5 (VDD), U5.5 (VDD); also elsewhere on the board
/ch584/PWM1: U9.3 (INA); also elsewhere on the board
/ch584/PWM2: U9.6 (INB); also elsewhere on the board
/ch584/PWM3: U2.4 (INA); also elsewhere on the board
/ch584/PWM4: U2.3 (INB); also elsewhere on the board
/ch584/PWM5: U4.4 (INA); also elsewhere on the board
/esp32/PWM7: U5.4 (INA); also elsewhere on the board
/esp32/PWM8: U5.3 (INB); also elsewhere on the board
GND: U2.2 (GND), U4.2 (GND), U5.2 (GND), U9.2 (GND); also elsewhere on the board
unnamed: C6.1, J11.1, J13.1, U9.4 (OUTA)
unnamed: C6.2, J11.2, J13.2, U9.1 (OUTB)
unnamed: C5.1, J6.1, J14.1, U2.6 (OUTA)
unnamed: C5.2, J6.2, J14.2, U2.1 (OUTB)
unnamed: C4.1, J7.1, J15.1, U4.6 (OUTA)
unnamed: C4.2, J7.2, J15.2, U4.1 (OUTB)
unnamed: C3.1, J8.1, J16.1, U5.6 (OUTA)
unnamed: C3.2, J8.2, J16.2, U5.1 (OUTB)
unnamed: JP3.2 (B), U9.5 (VDD)
RESET_CH5x: U4.3 (INB); also elsewhere on the board

Notes on the sheet:
So, let's experiment... can you really get more current? or is it just marketting.. (that's also why we can't just use sheet copies for this)
put a 1x4 on each one? for extension via pins, not just the connectors?
Allow providing other power on the jumper, this channel can do 40V, in theory...
Try and split these power? to eval the drivers separately?
fm116c: 0.04, 60k stock (600/800mA) ad116: 0.04, 3k stock (1.1/2A) lk116: 0.04 200 stock (1A/2A) t1016h: 0.05 4k stock (2.3A) bdr6120: 0.05 ~zero stock gr6205: 0.03 2k stock (200mA) hl116: 0.03 3k stock (500/800mA)

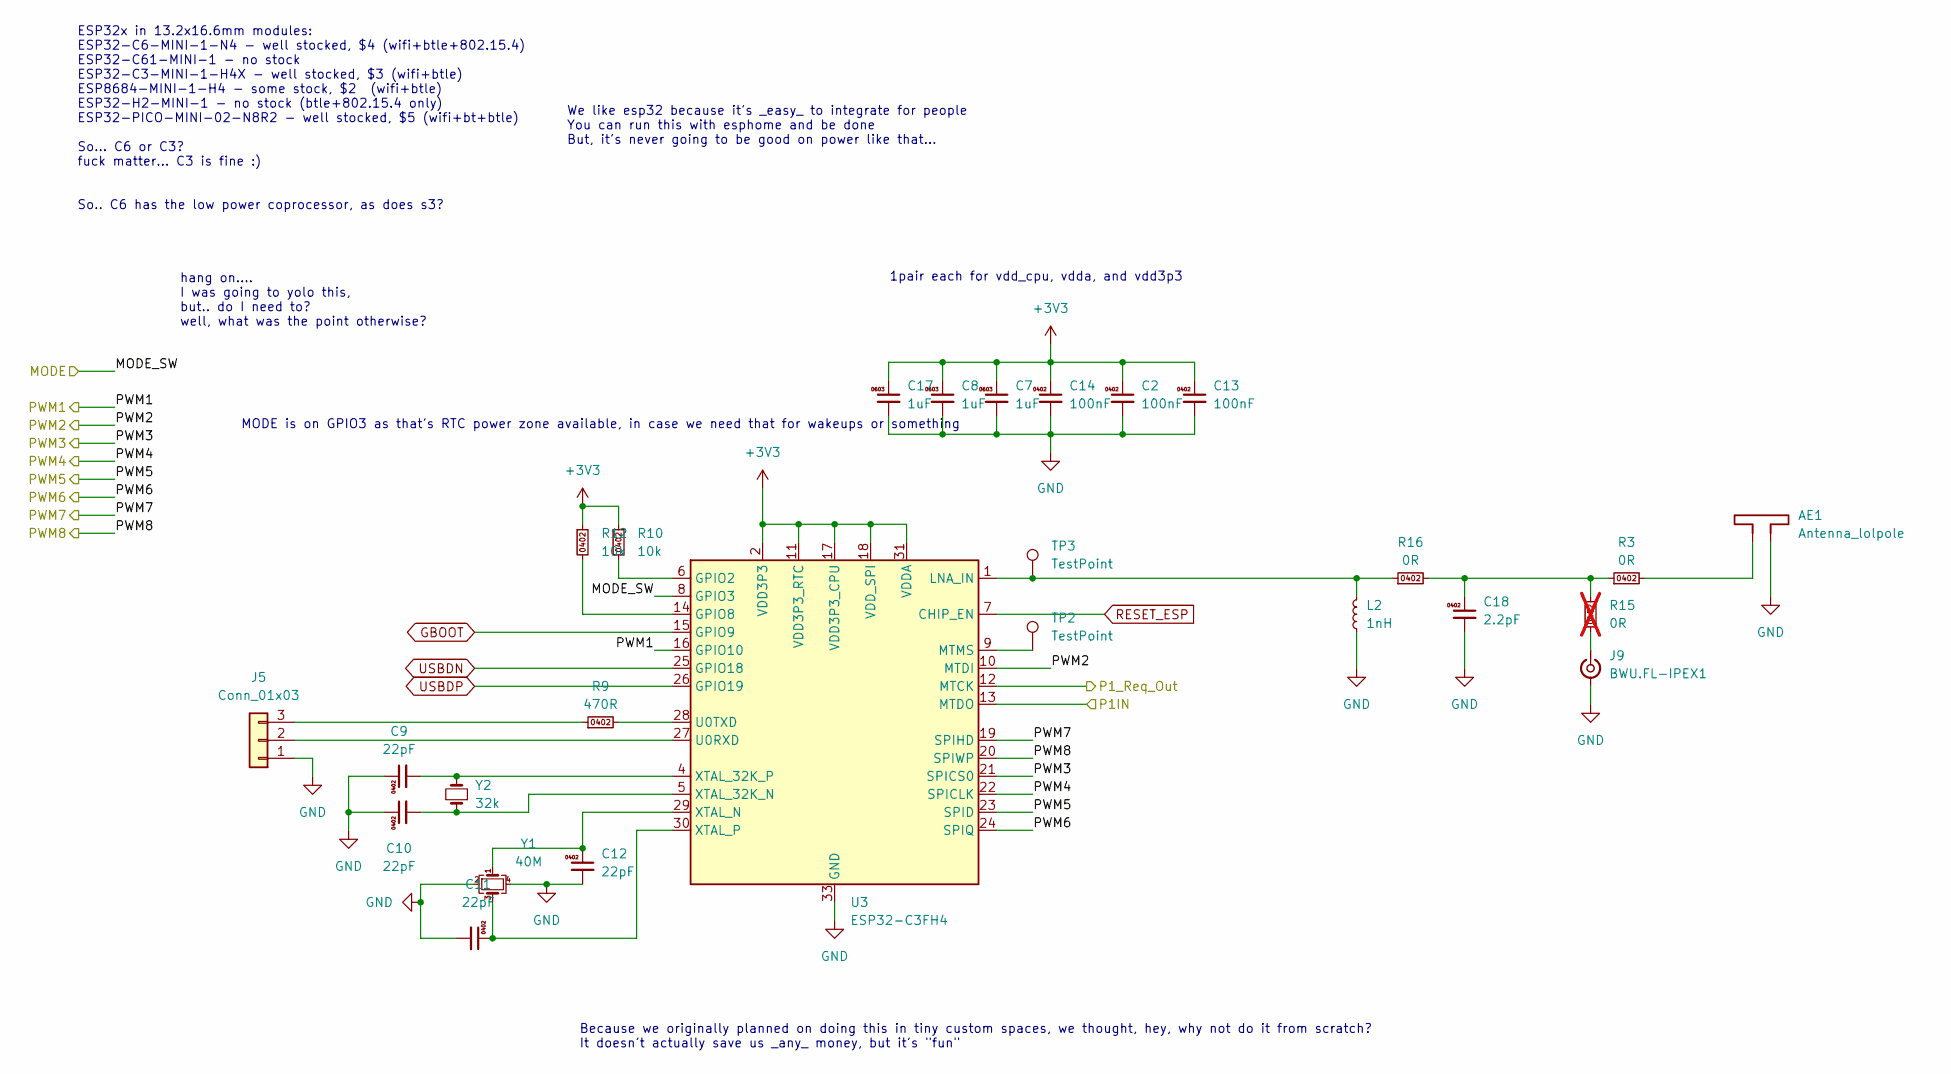
[picture p12: schematic esp32.kicad_sch]

Parts:
AE1: Antenna_lolpole; ANT-YOLOPOLE
C2, C13, C14: 100nF; C_0402_1005Metric; MPN CL05B104KO5NNNC; LCSC Part # C1525
C7, C8, C17: 1uF; C_0603_1608Metric; MPN CL10A105KB8NNNC; LCSC Part # C15849
C9, C10, C11, C12: 22pF; C_0402_1005Metric; MPN 0402CG220J500NT; LCSC Part # C1555
C18: 2.2pF; C_0402_1005Metric; MPN 0402CG2R2C500NT; LCSC Part # C1559
J5: Conn_01x03; PinHeader_1x03_P2.54mm_Vertical
J9: BWU.FL-IPEX1; U.FL_Hirose_U.FL-R-SMT-1_Vertical; MPN BWU.FL-IPEX1; LCSC Part # C5137195
L2: 1nH; L_0402_1005Metric; MPN LQG15HS1N0S02D; LCSC Part # C18222
R3, R16: 0R; R_0402_1005Metric; MPN 0402WGF0000TCE; LCSC Part # C17168
R9: 470R; R_0402_1005Metric; MPN 0402WGF4700TCE; LCSC Part # C25117
R10, R12: 10k; R_0402_1005Metric; MPN 0402WGF1002TCE; LCSC Part # C25744
R15: 0R; R_0402_1005Metric; MPN 0402WGF0000TCE; LCSC Part # C17168; not fitted
TP2: TestPoint; TestPoint_THTPad_D1.0mm_Drill0.5mm
TP3: TestPoint; TestPoint_Pad_D1.0mm
U3: ESP32-C3FH4; QFN-32-1EP_5x5mm_P0.5mm_EP3.7x3.7mm; MPN ESP32-C3FH4; LCSC Part # C2858491
Y1: 40M; Crystal_SMD_2016-4Pin_2.0x1.6mm; MPN TAXM40M4ZHBCDT2T; LCSC Part # C424432
Y2: 32k; Crystal_SMD_3215-2Pin_3.2x1.5mm; MPN Q13FC13500004; LCSC Part # C32346

Connections:
+3V3: C2.1, C7.1, C8.1, C13.1, C14.1, C17.1, R10.1, R12.1, U3.2 (VDD3P3), U3.3 (VDD3P3), U3.11 (VDD3P3_RTC), U3.17 (VDD3P3_CPU), U3.18 (VDD_SPI), U3.31 (VDDA), U3.32 (VDDA); also elsewhere on the board
/MODE: U3.8 (GPIO3); also elsewhere on the board
/ch584/PWM1: U3.16 (GPIO10); also elsewhere on the board
/ch584/PWM2: U3.10 (MTDI); also elsewhere on the board
/ch584/PWM3: U3.13 (MTDO), U3.21 (SPICS0); also elsewhere on the board
/ch584/PWM4: U3.22 (SPICLK); also elsewhere on the board
/ch584/PWM5: U3.12 (MTCK), U3.23 (SPID); also elsewhere on the board
/esp32/PWM7: U3.19 (SPIHD); also elsewhere on the board
/esp32/PWM8: U3.20 (SPIWP); also elsewhere on the board
GBOOT: U3.15 (GPIO9); also elsewhere on the board
GND: AE1.2, C2.2, C7.2, C8.2, C9.1, C10.1, C11.2, C12.2, C13.2, C14.2, C17.2, C18.2, J5.1, J9.2 (Ext), L2.1, U3.33 (GND), Y1.2, Y1.4; also elsewhere on the board
unnamed: AE1.1, R3.2
unnamed: C18.1, R3.1, R15.2, R16.2
unnamed: J5.2, U3.27 (U0RXD)
unnamed: J5.3, R9.1
unnamed: J9.1 (In), R15.1
unnamed: R10.2, U3.6 (GPIO2)
unnamed: R12.2, U3.14 (GPIO8)
unnamed: L2.2, R16.1, TP3.1 (1_1), U3.1 (LNA_IN)
unnamed: TP2.1 (1_1), U3.9 (MTMS)
unnamed: R9.2, U3.28 (U0TXD)
unnamed: C10.2, U3.5 (XTAL_32K_N), Y2.1
unnamed: C9.2, U3.4 (XTAL_32K_P), Y2.2
unnamed: C12.1, U3.29 (XTAL_N), Y1.1
unnamed: C11.1, U3.30 (XTAL_P), Y1.3
RESET_CH5x: U3.24 (SPIQ); also elsewhere on the board
RESET_ESP: U3.7 (CHIP_EN); also elsewhere on the board
USBDN: U3.25 (GPIO18); also elsewhere on the board
USBDP: U3.26 (GPIO19); also elsewhere on the board

Notes on the sheet:
hang on.... I was going to yolo this, but.. do I need to? well, what was the point otherwise?
MODE is on GPIO3 as that's RTC power zone available, in case we need that for wakeups or something
ESP32x in 13.2x16.6mm modules: ESP32-C6-MINI-1-N4 - well stocked, $4 (wifi+btle+802.15.4) ESP32-C61-MINI-1 - no stock ESP32-C3-MINI-1-H4X - well stocked, $3 (wifi+btle) ESP8684-MINI-1-H4 - some stock, $2 (wifi+btle) ESP32-H2-MINI-1 - no stock (btle+802.15.4 only) ESP32-PICO-MINI-02-N8R2 - well stoc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
Because we originally planned on doing this in tiny custom spaces, we thought, hey, why not do it from scratch? It doesn't actually save us _any_ money, but it's "fun"
We like esp32 because it's _easy_ to integrate for people You can run this with esphome and be done But, it's never going to be good on power like that...
1pair each for vdd_cpu, vdda, and vdd3p3

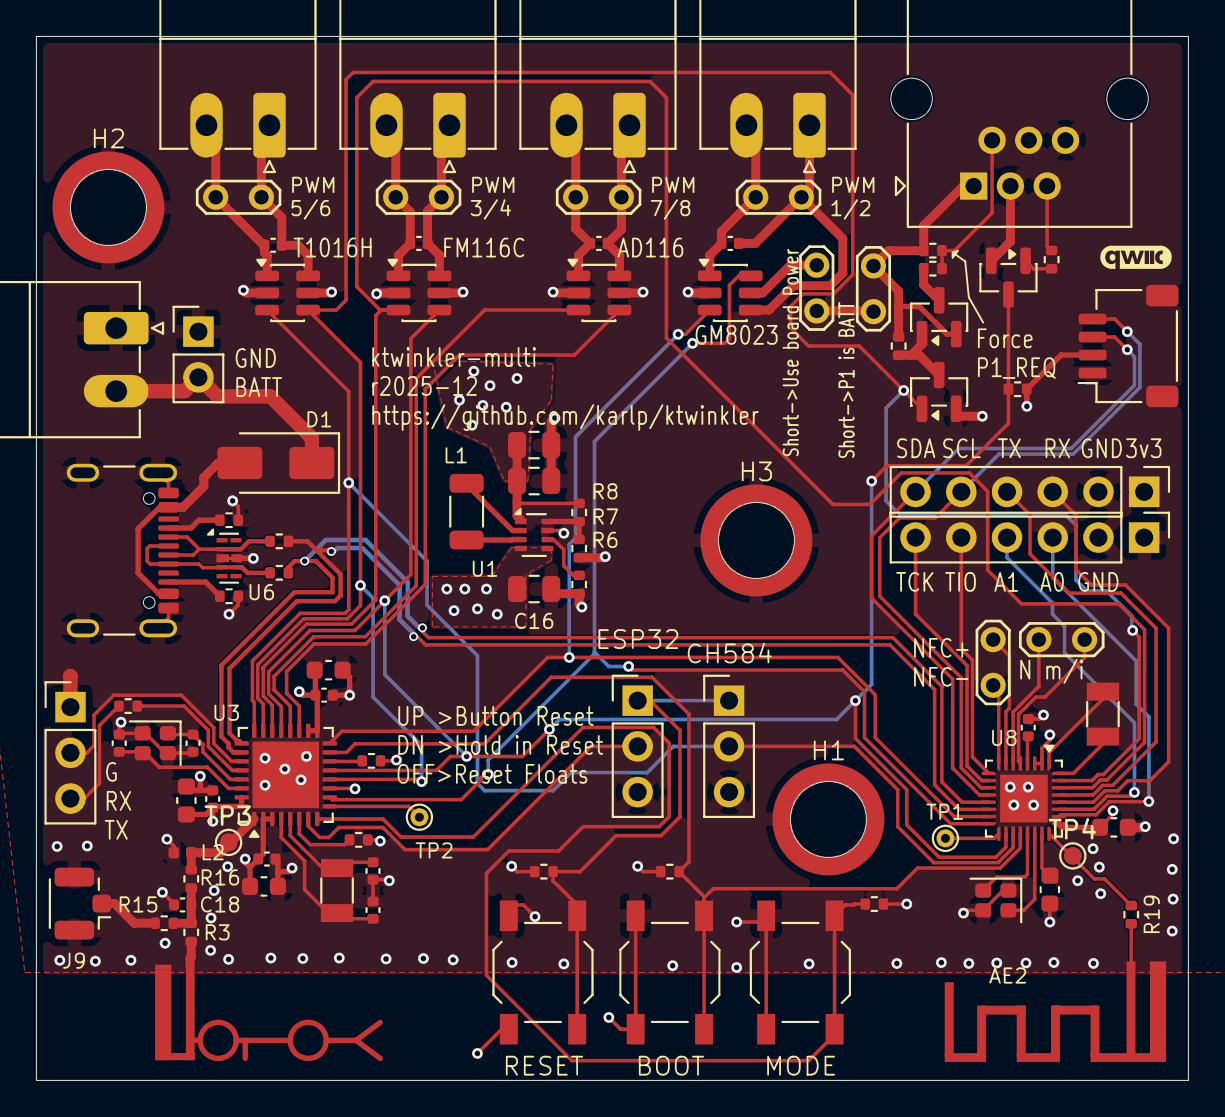
[picture p13: board ktwinkler-multi-r2025-12.kicad_pcb from above]

Board: 4 copper layers, 64.0 x 58.0 mm, 97 parts (0 on the bottom side), 77 nets.
