karlp/ktwinkler/fw/manifest.common.py

module("ptwinkler.py", base_path="src")
module("config_node.py", base_path="src")
module("home.py", base_path="src")
module("secrets.py", base_path="src")
module("test_artnet1_async.py", base_path="src")

module("main.py", base_path="src")
