karlp/ktwinkler/(commit log)

2025-11-05 let's goooo
    [ktwinkler-r2025-11.kicad_pcb, ktwinkler-r2025-11.kicad_sch]
2025-11-17 pushing ideas around
    [ktwinkler-r2025-11.kicad_pcb, ktwinkler-r2025-11.kicad_sch]
2025-11-17 test mpy code to verify that it works
    ran this with the antiparallel led strips driven by drv8833.
    should be fine with ~any cheap 1ch driver too.
2025-12-02 import draft play as a new board
    [ktwinkler-multi-r2025-12.kicad_pcb, ktwinkler-multi-r2025-12.kicad_sch]
2025-12-02 make a v2 idea, mroe experiments, less product...
    [esp32.kicad_sch, ktwinkler-multi-r2025-12.kicad_sch, ktwinkler-r2025-11.kicad_sch, leds.kicad_sch, power.kicad_sch]
2025-12-04 ktwinkler hw dev: progress stash
    [esp32.kicad_sch, leds.kicad_sch, power.kicad_sch]
2025-12-09 pushing onwards like a madlad
    [ch584.kicad_sch, esp32.kicad_sch, ktwinkler-multi-r2025-12.kicad_pcb, ktwinkler-multi-r2025-12.kicad_sch, leds.kicad_sch, power.kicad_sch]
2025-12-11 ready for scope creep
    I think the schematic is ... mostly ok? I need to decide how much of
    the han p1 port scope creep to bother doing, or not...
    I've roughyl blocked out the board, seems as good as any?
    [ch584.kicad_sch, esp32.kicad_sch, ktwinkler-multi-r2025-12.kicad_pcb, ktwinkler-multi-r2025-12.kicad_sch, leds.kicad_sch, power.kicad_sch, scope_creep.kicad_sch]
2025-12-16 this is just getting silly
    [ch584.kicad_sch, esp32.kicad_sch, ktwinkler-multi-r2025-12.kicad_pcb, ktwinkler-multi-r2025-12.kicad_sch, scope_creep.kicad_sch]
2025-12-18 "schematic complete" (lol)
    but yeah, i think this is most of it? time to maybe route shit?
    [ch584.kicad_sch, esp32.kicad_sch, ktwinkler-multi-r2025-12.kicad_pcb, ktwinkler-multi-r2025-12.kicad_sch, scope_creep.kicad_sch]
2025-12-25 update following ERC and symbol fixes
    [ch584.kicad_sch, esp32.kicad_sch, ktwinkler-multi-r2025-12.kicad_pcb, ktwinkler-multi-r2025-12.kicad_sch, leds.kicad_sch, power.kicad_sch, scope_creep.kicad_sch]
2025-12-25 streammmm updates
    "complete" apart from finishing those antennas.
    needs DRC cleanups on both the wch inv-f and also the yolo-pole.
    need to at least _basically_ get the antenna trace basic wdith correct
    as well. yolo is fine, when it's guided yolo, not "lol"
    [ch584.kicad_sch, esp32.kicad_sch, ktwinkler-multi-r2025-12.kicad_pcb, ktwinkler-multi-r2025-12.kicad_sch, power.kicad_sch]
2026-01-09 attempting to progres towards a build
    [ktwinkler-multi-r2025-12.kicad_pcb, ktwinkler-multi-r2025-12.kicad_sch]
2026-03-10 first play PIFA sim
    Adds the 2.2 demos, emerge did a major release while we were
    daydreaming.
    Adds our very initial PIFA sim, which is not at all complete, but, it's
    a start. Adds a kicad footprint, we eventually want to turn a kicad
    footprint into an emerge model "automagically" for this sort of
    thing....
    [DielectricRod.step]
2026-03-24 hw: save before kicad 10 upgrade
    [ch584.kicad_sch, ktwinkler-multi-r2025-12.kicad_pcb, ktwinkler-multi-r2025-12.kicad_sch, scope_creep.kicad_sch]
2026-03-24 hw: update to kicad 10 and order
    We added a late qwiic connector to the ch584 side, why not, try that out
    too. We also fixed our smtso footprint, we hope...
    Fuck poking the rf more, we're yolo-poling...
    [ch584.kicad_sch, esp32.kicad_sch, ktwinkler-multi-r2025-12.kicad_pcb, ktwinkler-multi-r2025-12.kicad_sch, leds.kicad_sch, power.kicad_sch, scope_creep.kicad_sch]
2026-04-19 hw/ktwinkler-multi: fix the bi/uni tvs fuckup
    We're not likely to make a new version of _exactly_ this board, but
    don't leave the totally busted short circuit around to stumble on later!
    [ktwinkler-multi-r2025-12.kicad_pcb, power.kicad_sch]
2026-04-20 hw/multi-rev2025: flag more total fuckups in the design
    lol, using 6 PWMs on the internal spi channel. I've read that section
    multiple times, and just... wot? oh well. Cut a few traces, can still
    do some things...
    [esp32.kicad_sch]
2026-04-20 fw: move proto twinkle to fw src
    And update for the only functional pwm pins on current hw, for esp32
    side at least.
2026-04-20 Add micropython board definition for esp32 side
    [partitions-4MiBplus.csv, pins.csv]
2026-09-17 hw: 2025-12: pin some libraries and synch files
    no changes of interest
2026-09-17 lol, as if this will be done in time.
    [esp32.kicad_sch, ktwinkler-24-basic1.kicad_pcb, ktwinkler-24-basic1.kicad_sch, leds.kicad_sch, power.kicad_sch]
2026-09-20 ktwinkler-24: schematic "complete"
    [calculations.ods, esp32.kicad_sch, ktwinkler-24-basic1.kicad_sch, leds.kicad_sch, power.kicad_sch]
2026-09-20 k24: rough blocked, fixed old values for bucks
    [ktwinkler-24-basic1.kicad_pcb, power.kicad_sch]
2026-09-20 k24-basic1: first cut layout complete
    re(un)twisted all the outputs to be straight.
    seems like this is all it needs... yolo?
    [esp32.kicad_sch, ktwinkler-24-basic1.kicad_pcb, leds.kicad_sch, power.kicad_sch]
2026-09-21 24-1: connect some planes that were independent
    other little tidy ups
    [ktwinkler-24-basic1.kicad_pcb, ktwinkler-24-basic1.kicad_sch]
2026-09-21 k24-1: mounting, rounding labels
    save point before retrying thigns
    [esp32.kicad_sch, ktwinkler-24-basic1.kicad_pcb, ktwinkler-24-basic1.kicad_sch, power.kicad_sch]
2026-09-21 24-basic1: ordered and sent off
    sw time!
    [ktwinkler-24-basic1.kicad_pcb]
2026-09-22 hw: 24-basic1: update spreadsheet
    [calculations.ods]
2026-09-22 fw: twinkler.py don't abort on boards without named pins
    We don't all have custom board files, make sure it doesn't fail to
    import at least.
    [twinkler.py]
2026-09-22 fw: update to micropython 1.29 as learned
    We used the https://github.com/karlp/kgarden3 to figure out new
    micropython custom board setups, but decided to just keep it all here in
    the end, so update here neatly.
2026-09-22 fw/boards: add mpy for 24-basic1
    compiles clean, but it's basically just a pins definition at this point.
    [partitions-4MiBplus.csv, pins.csv]
2026-09-22 import test code from old kgarden3 repo
    Testing multicast in micropython, and a script for testing wifi rangfe
    in the garden on a board without a screen.
2026-09-22 very preliminary working artnet receiver
    we manually setup two, two channel dimmers in qlcplus5, and can see the
    knobs cause values to arrive on our esp32 board.
2026-09-23 twinkler: quick checks on how fast it has to swap to avoid flicker
    spoiler, it might need to be smarter, but for now, "just go faster!"
    [twinkler.py]
2026-09-23 demonstrate dumb artnet with asyncio
    connected to our async twinkler.
    using both dimmer channels with two twinklers really flickers badly
    though. it will probably need to have only a single "maintain" task per
    board, not per logical h-bridge channel to have any chance, but hey,
    logical and simple and naiive first amirite?
2026-09-24 exploring where my performance is dying.
    I suspect we're copying too much data around, and need to refer to it as
    object members instead.
    [test_artnet1_async.py]
2026-09-29 host test udp sender
    used to create consistent streams of udp data, to avoid relying on
    having the artnet control plane in place.
    [ht_send_udp.py]
2026-09-29 fw/config: add more local boards I was testing with
2026-09-29 test udp rx: add all four modes to a single file
    Now runnable standalone on any mpy board...
2026-09-29 test udp rx: add platform print
2026-09-30 atwinkler: attempt to only work when needed
    Doesn't seem to make much difference. It obviously helps for the single
    colour cases, but those were never a problem. For bi-colour operation,
    this doesn't make enough impact.
    [atwinkler.py]
2026-10-28 adjust podman volume mount to make git versions work better
2026-10-28 tighten up the dmx address space.
    No reason to be up at 100 or so.
2026-10-28 preliminary, not complete artnet poll reply
    It shows up in the node list of qlc5, though... you can't do anythign
    with it, but it doesn't show up in air2dmx [1]. Wireshark shows it as
    "malformed" but I'm not sure what's malformed yet.
    It _does_ show up in ArtNet DMX Tool[2] with no complaints though. No
    idea what the problem is.
    [1] https://play.google.com/store/apps/details?id=com.jms.dmxlightdesk
    [2] https://play.google.com/store/apps/details?id=com.electrotas.artnettool
